Mambix/TroublemakerMX/README.md

# TroublemakerMX
Upgrade of Troublemaker 3D printer
