Mambix/TroublemakerMX/pdf/6mm_gravura_prva_stran.pdf

5-*-6

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
# HEATBED

# HOTEND II

# HOTEND I

## NONE

## NONE

## Z-MAX

## Z-MIN

## Y-MAX

## Y-MIN

## X-MAX

## X-MIN

GND
OUT
5V | - A | + D595/7
