Mambix/TroublemakerMX/dxf/6mm_plywood_cut_front_back.dxf

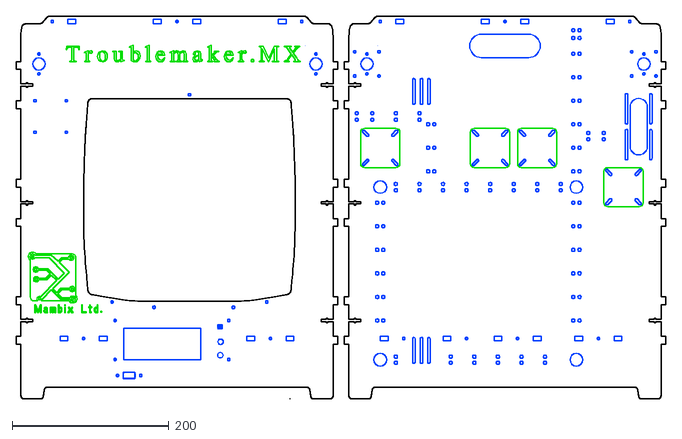
[picture p1: CAD file, 2021-01-03]
dxf/6mm_plywood_cut_front_back.dxf
828.0 x 488.0
