Mambix/TroublemakerMX/dxf/blocks/6mm_les_izrez_desno - LM8UU.dxf

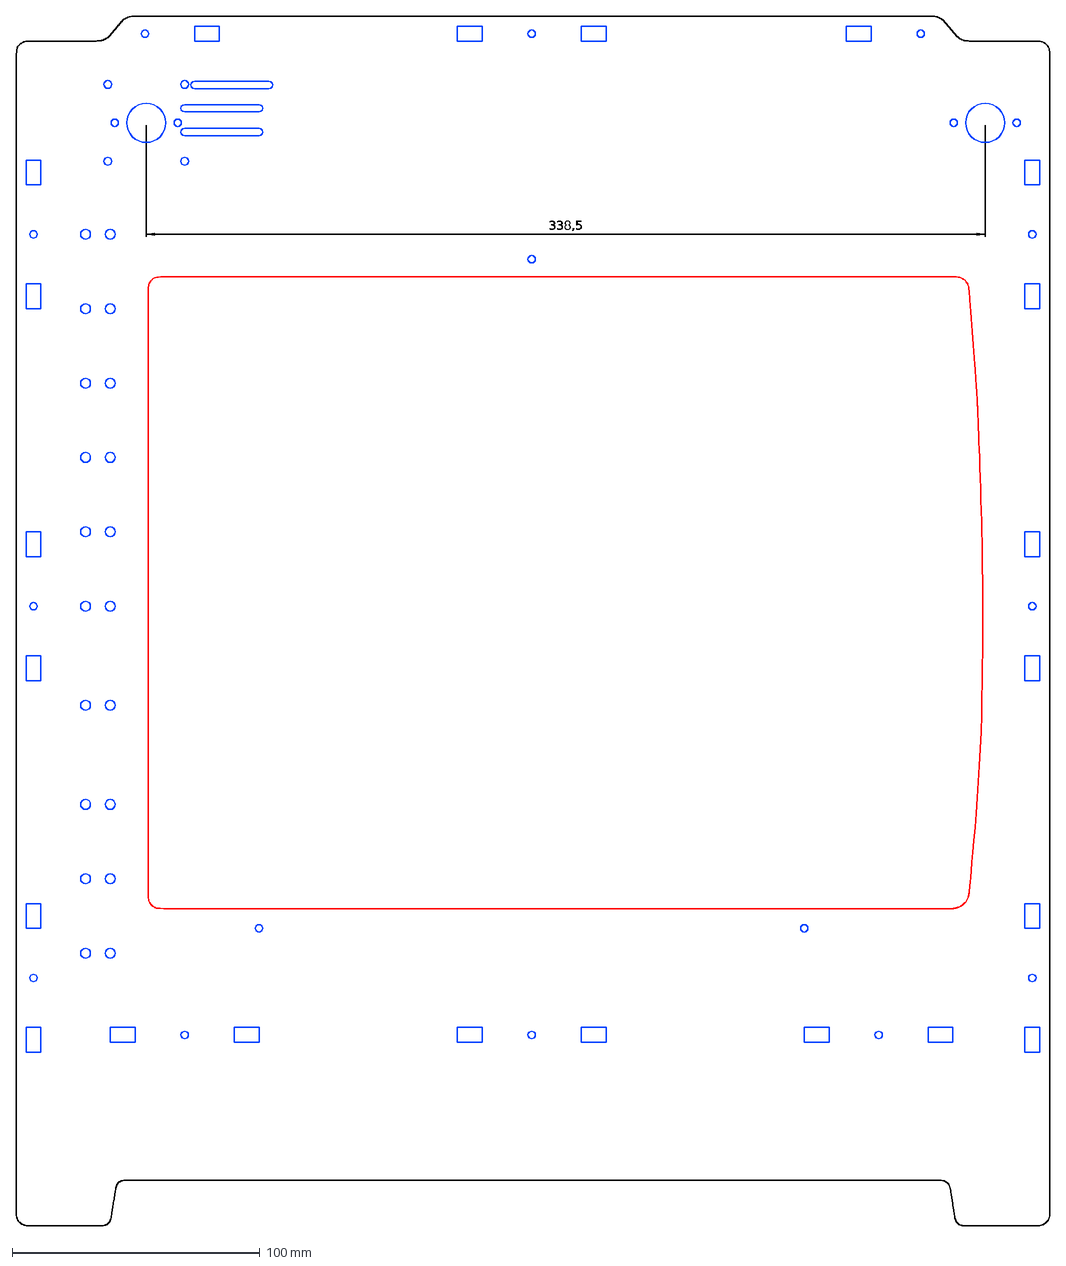
[picture p2: CAD file, 2021-01-03]
dxf/blocks/6mm_les_izrez_desno - LM8UU.dxf
338,5
