Mambix/TroublemakerMX/FreeCAD/LM8UU BallBearing Carrige #2.FCStd

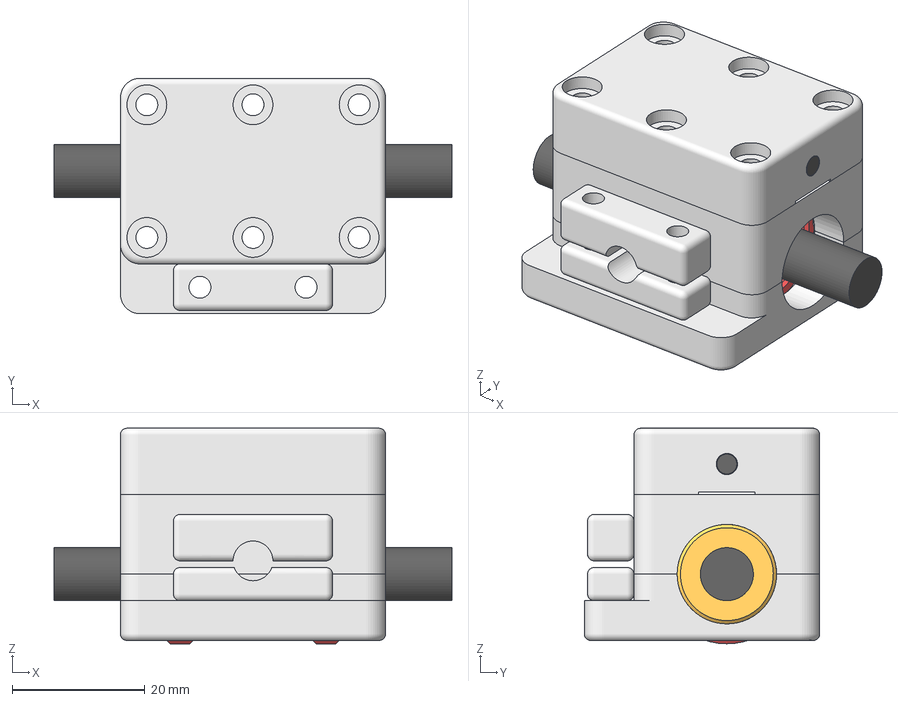
[picture p3: CAD file, 2017-03-12]
FreeCAD/LM8UU BallBearing Carrige #2.FCStd
60.0 x 35.5 x 32.5 mm
LM8UU
SUPPORT BOTTOM
SUPPORT TOP
6702ZZ #1
6702ZZ #2
TOP
BOTTOM
MIDDLE
GripPart
