Mambix/TroublemakerMX/stl/movedTOP.stl

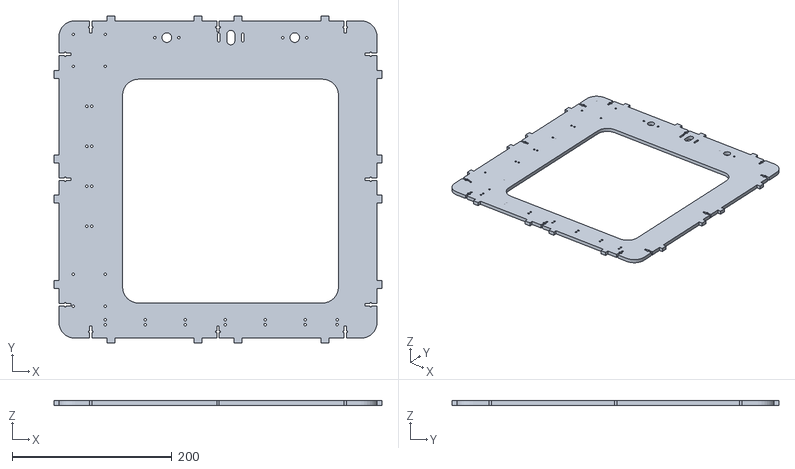
[picture p4: CAD file, 2021-01-03]
stl/movedTOP.stl
410.0 x 409.0 x 6.00
