Mambix/TroublemakerMX/dxf/6mm_plywood_cut_left_right.dxf

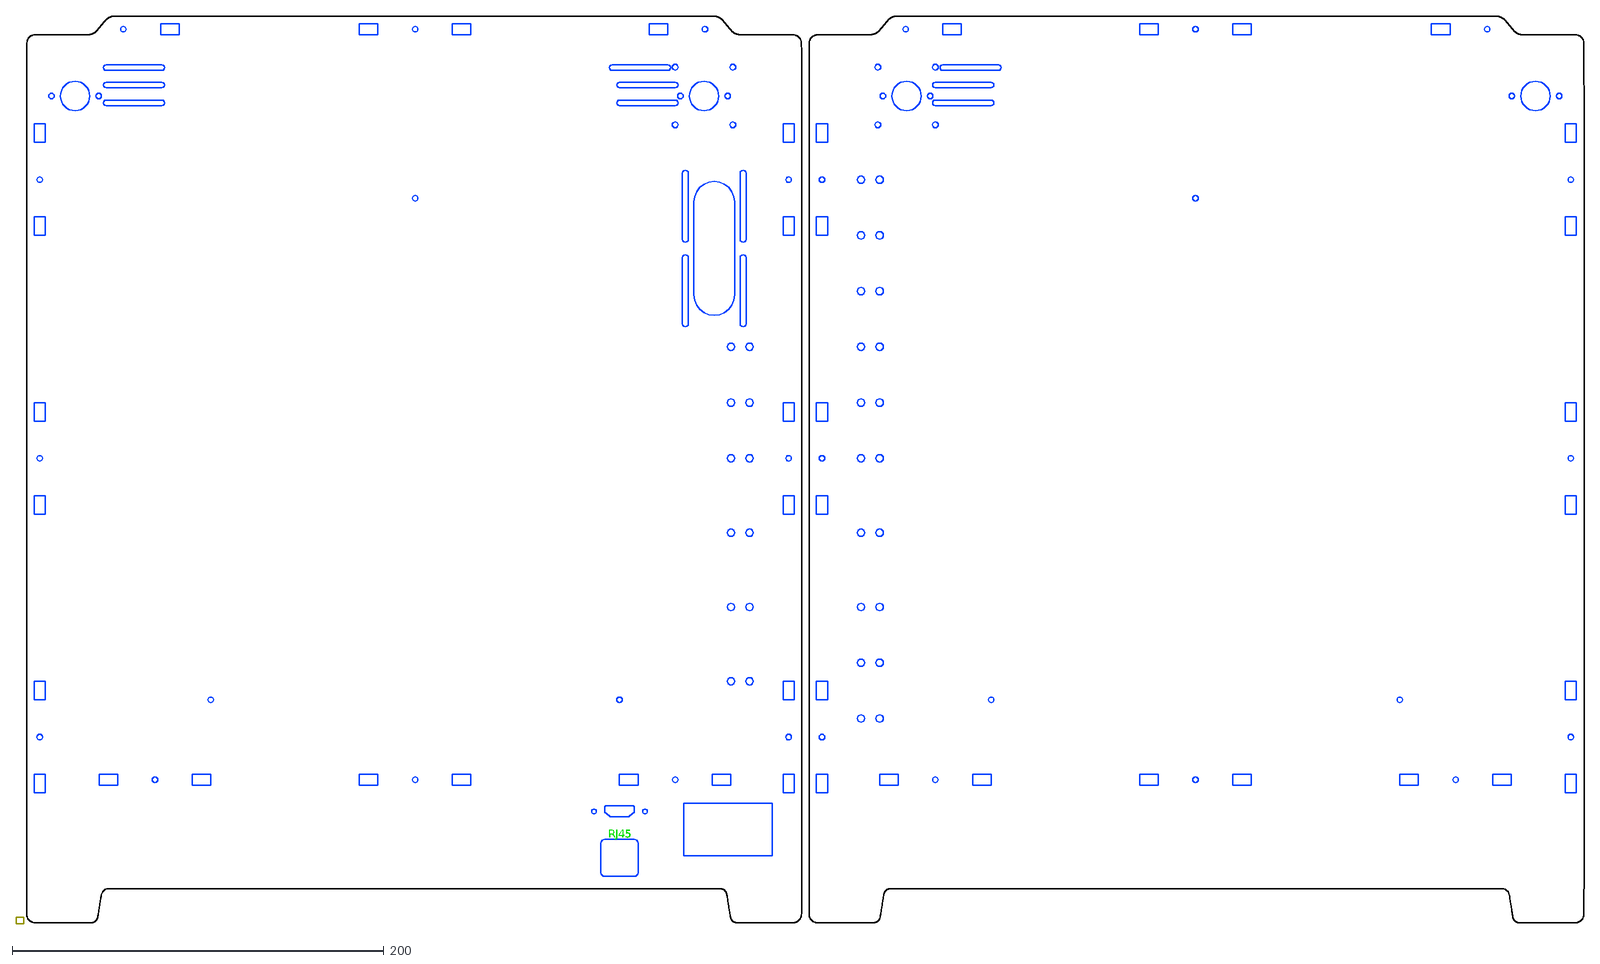
[picture p5: CAD file, 2021-01-03]
dxf/6mm_plywood_cut_left_right.dxf
RJ45
