Mambix/TroublemakerMX/dxf/blocks/6mm_les_izrez_levo - LM8UU.dxf

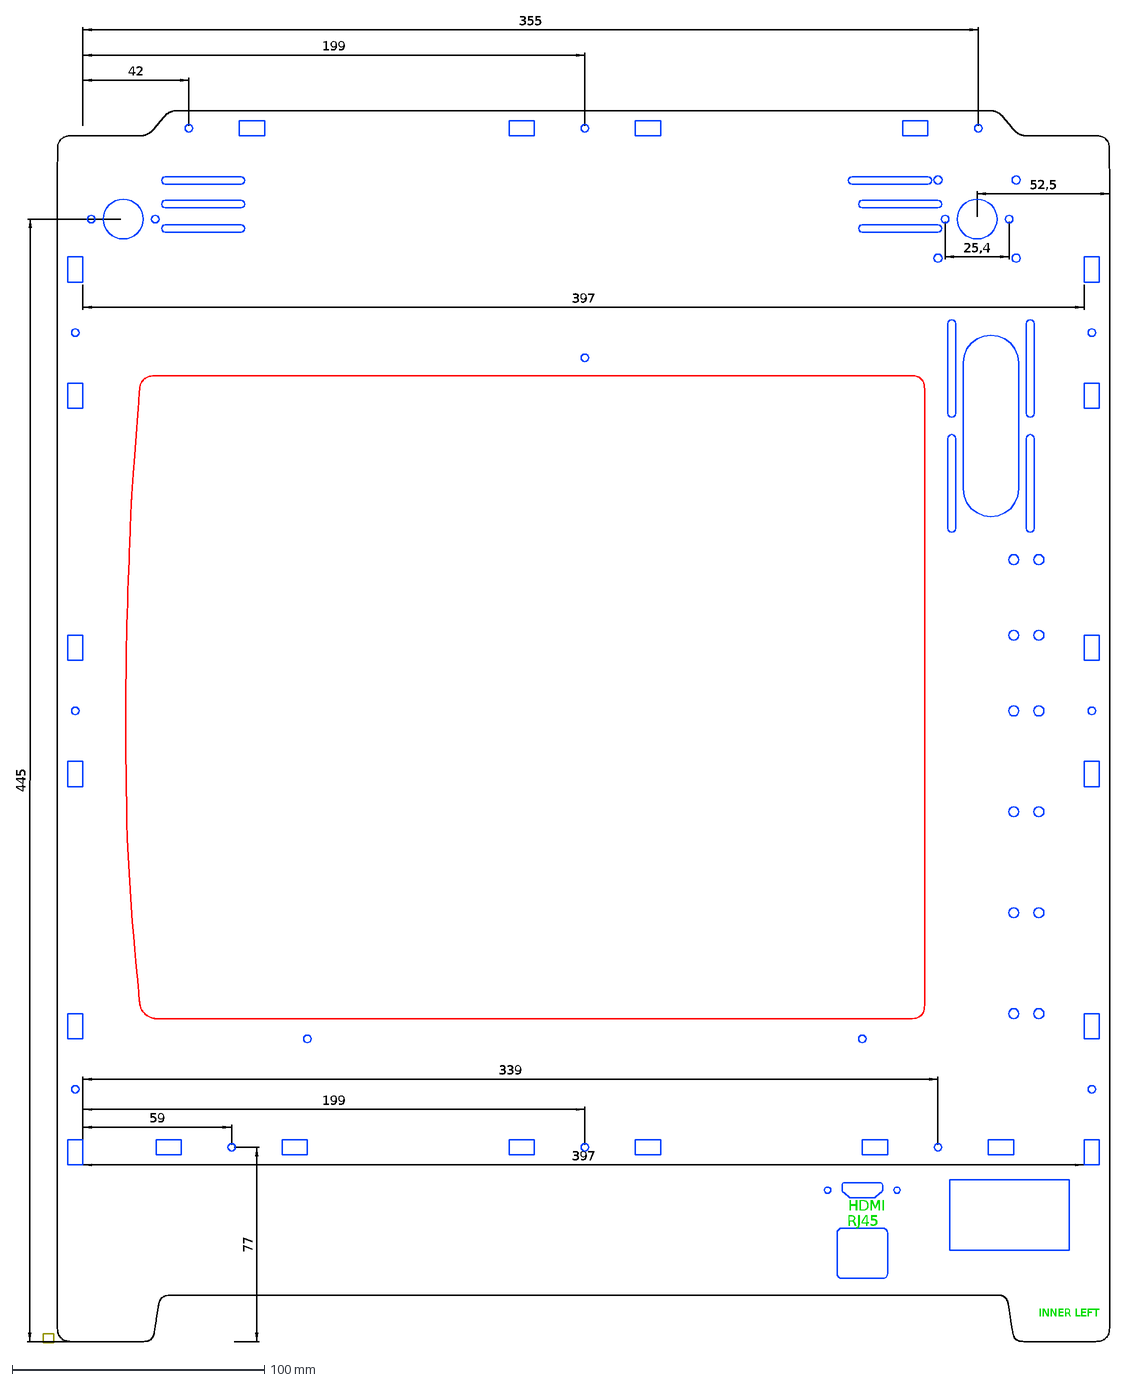
[picture p6: CAD file, 2021-01-03]
dxf/blocks/6mm_les_izrez_levo - LM8UU.dxf
INNER LEFT
77
397
42
199
355
59
339
25,4
445
HDMI
RJ45
52,5
