Mambix/TroublemakerMX/FreeCAD/3D Model.FCStd

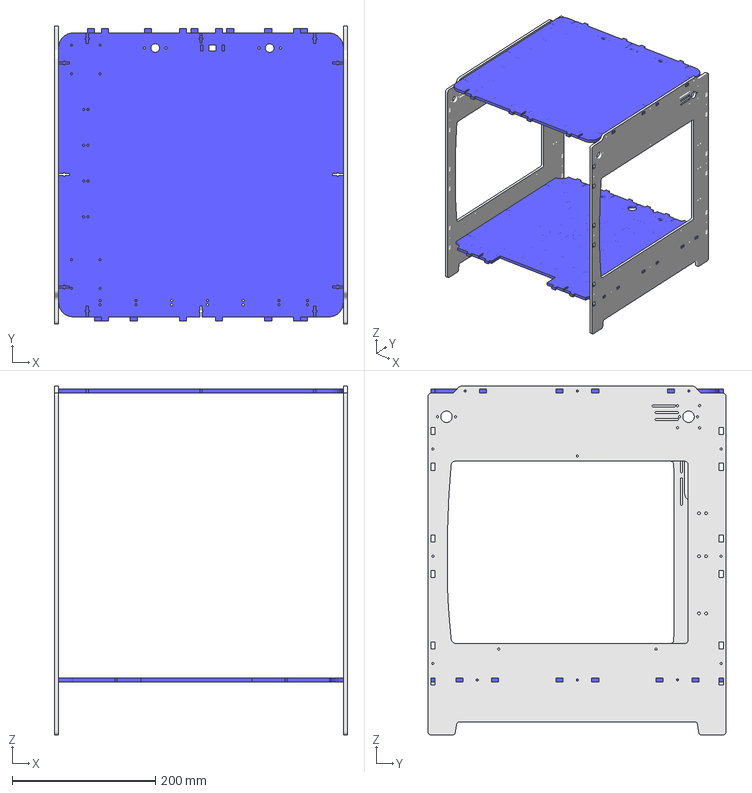
[picture p7: CAD file, 2017-03-03]
FreeCAD/3D Model.FCStd
410.0 x 417.1 x 488.0 mm
movedDOL
movedGOR
movedDESNO
movedLEVO
