Mambix/TroublemakerMX/stl/movedHE_BOTTOM.stl

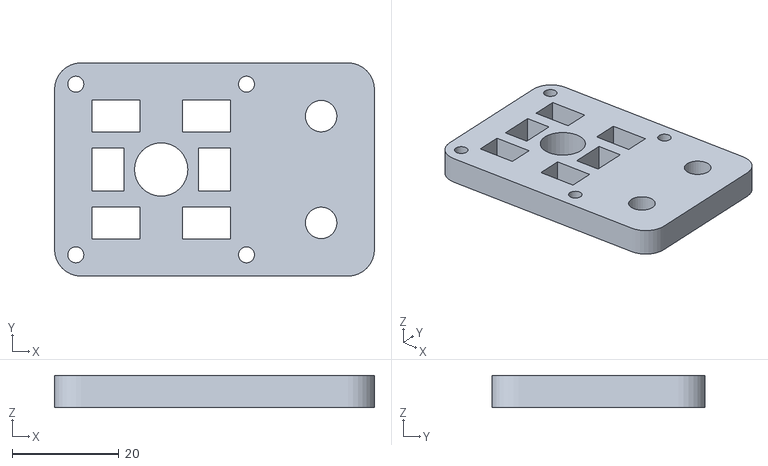
[picture p8: CAD file, 2021-01-03]
stl/movedHE_BOTTOM.stl
60.0 x 40.0 x 6.00
