Mambix/TroublemakerMX/dxf/6mm_plywood_cut_top_bottom.dxf

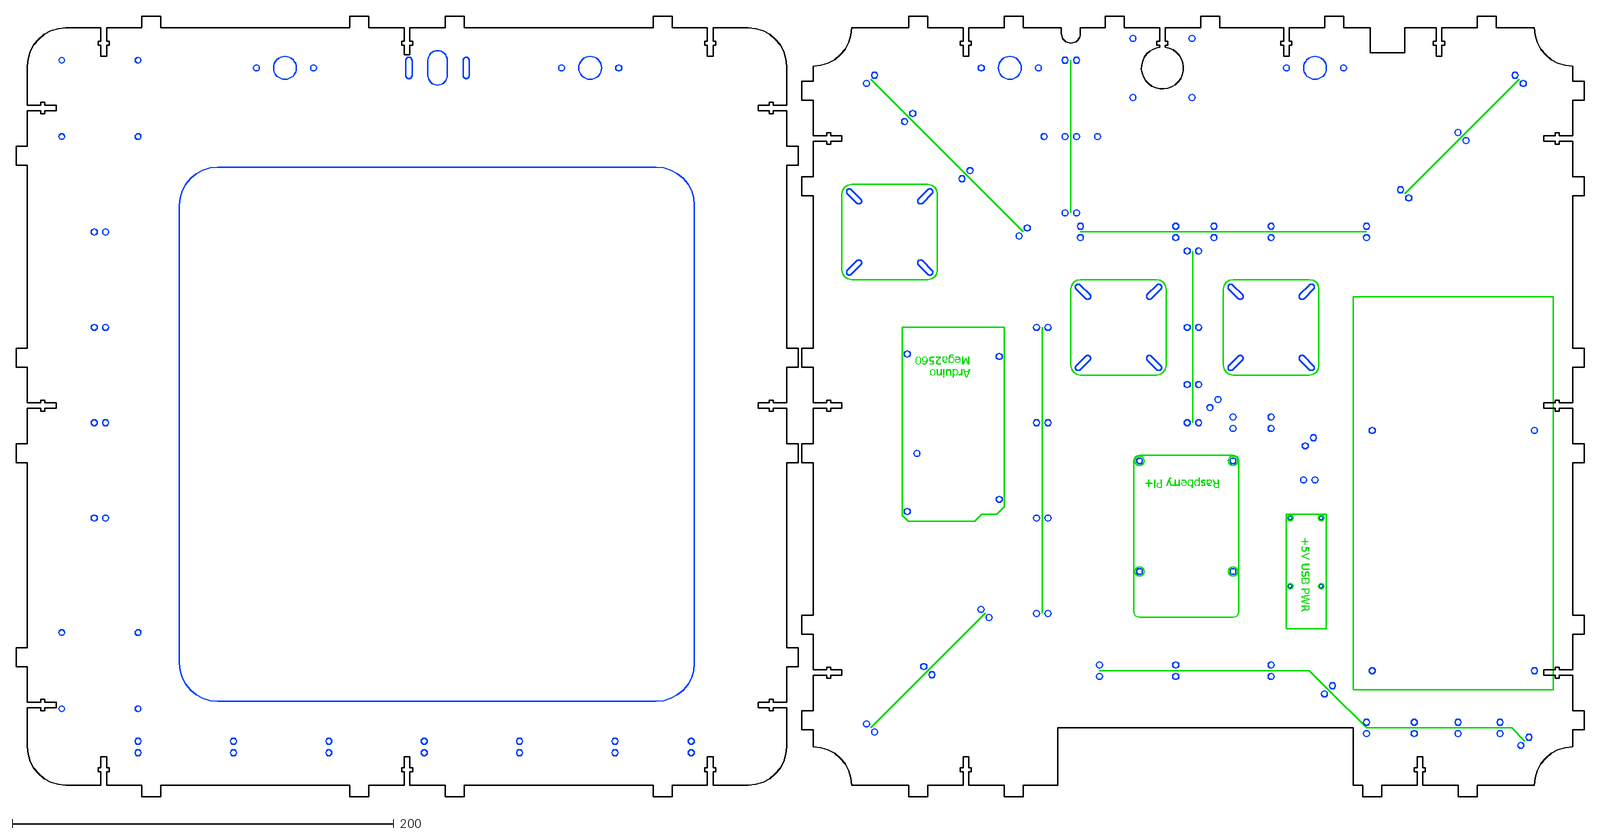
[picture p9: CAD file, 2021-01-03]
dxf/6mm_plywood_cut_top_bottom.dxf
Arduino Mega2560
Raspberry PI+
+5V USB PWR
