Mambix/TroublemakerMX/dxf/blocks/6mm_les_izrez_dol - LM8UU.dxf

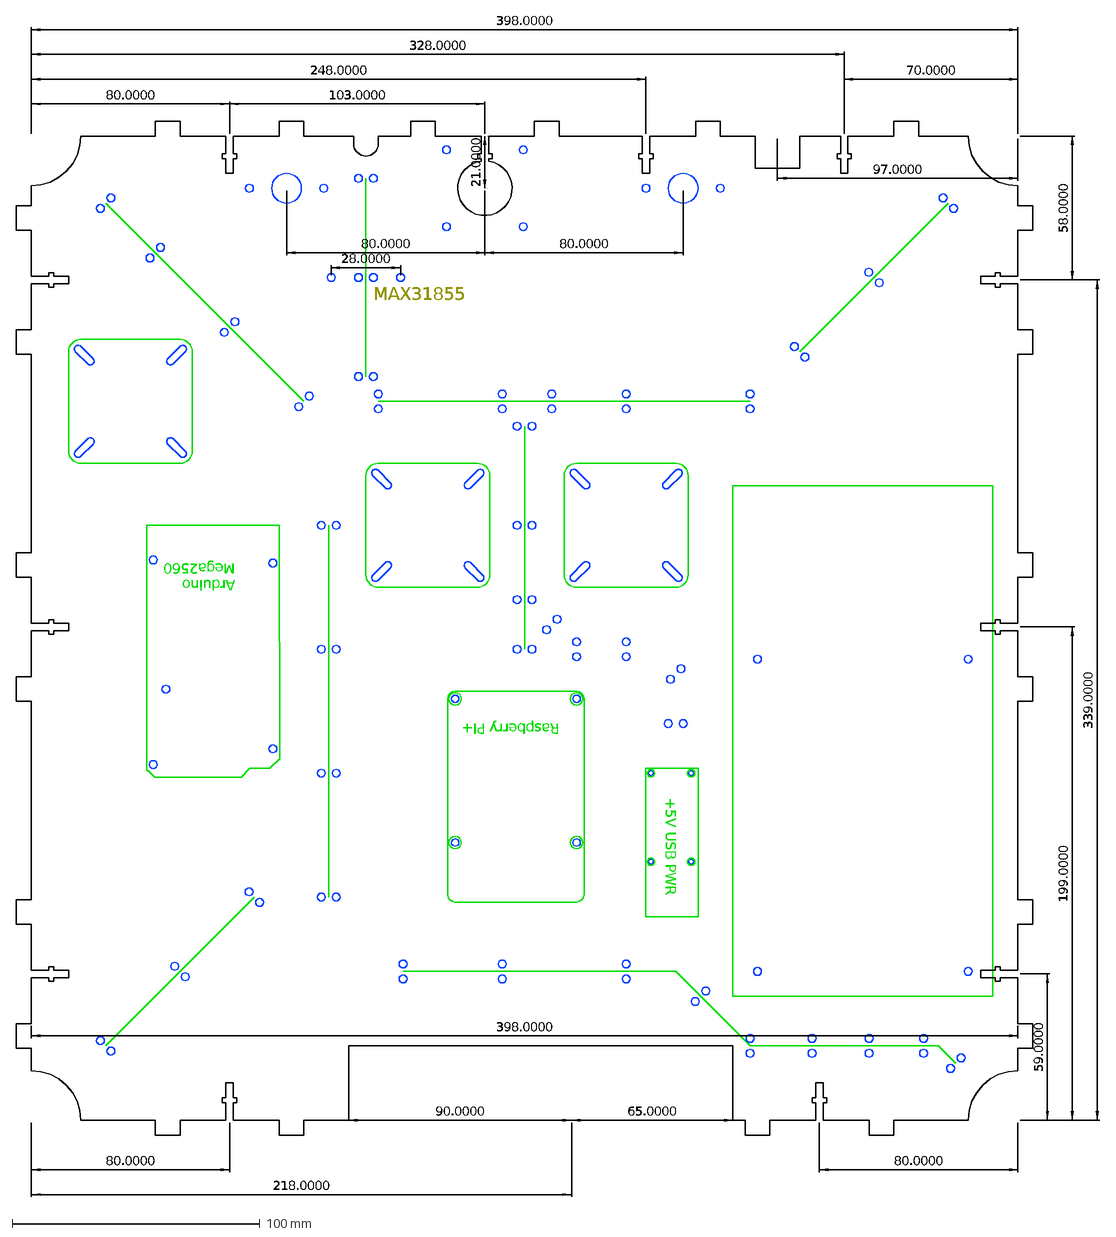
[picture p10: CAD file, 2021-01-03]
dxf/blocks/6mm_les_izrez_dol - LM8UU.dxf
MAX31855
Arduino Mega2560
Raspberry PI+
+5V USB PWR
248.0000
328.0000
70.0000
398.0000
80.0000
103.0000
21.0000
97.0000
58.0000
339.0000
199.0000
28.0000
218.0000
90.0000
65.0000
59.0000
