Mambix/TroublemakerMX/FreeCAD/3D Model gor dol.FCStd

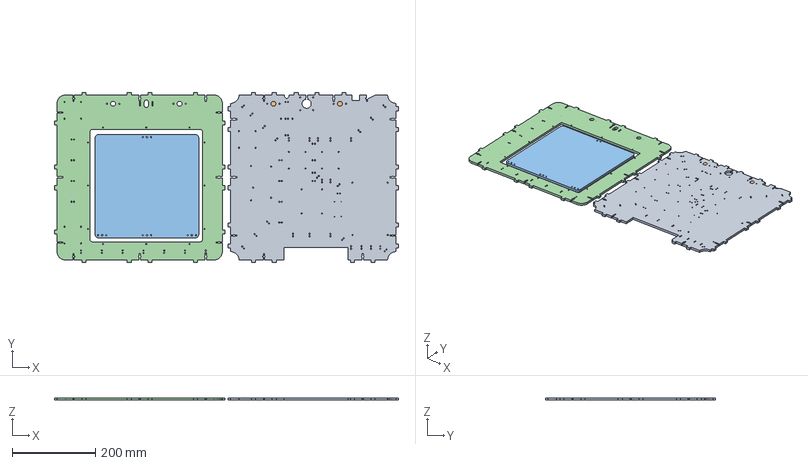
[picture p11: CAD file, 2017-02-22]
FreeCAD/3D Model gor dol.FCStd
828.0 x 409.0 x 6.00 mm
BOTTOM
TABLE
TOP
