Mambix/TroublemakerMX/stl/movedBOTTOM.stl

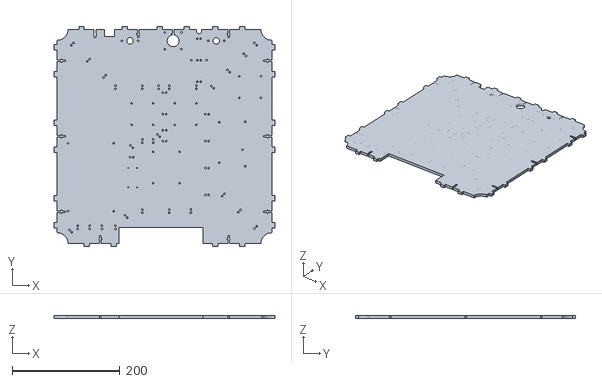
[picture p12: CAD file, 2021-01-03]
stl/movedBOTTOM.stl
410.0 x 409.0 x 6.00
