Mambix/TroublemakerMX/dxf/6mm_plexi_cut_windows.dxf

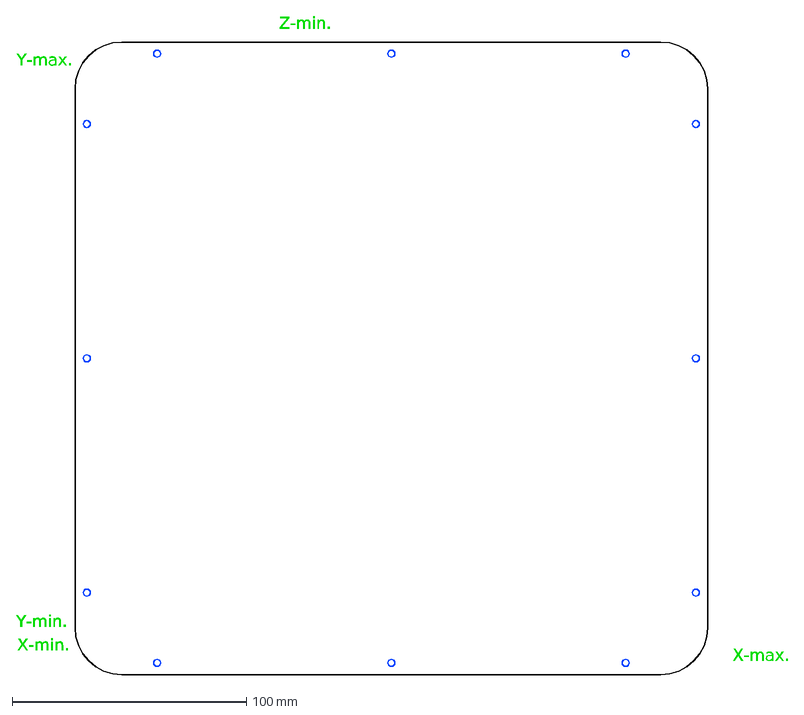
[picture p13: CAD file, 2018-02-03]
dxf/6mm_plexi_cut_windows.dxf
X-min.
Y-min.
Y-max.
Z-min.
X-max.
