Mambix/TroublemakerMX/dxf/blocks/6mm_les_izrez_zadaj - LM8UU.dxf

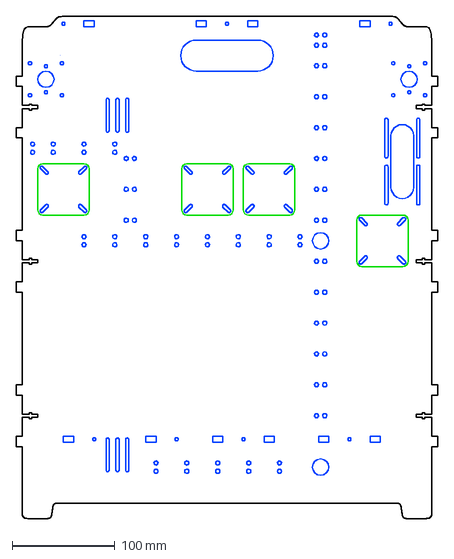
[picture p14: CAD file, 2021-01-03]
dxf/blocks/6mm_les_izrez_zadaj - LM8UU.dxf
410.0 x 488.0 mm
