Mambix/TroublemakerMX/FreeCAD/LM8UU BallBearing Carrige.FCStd

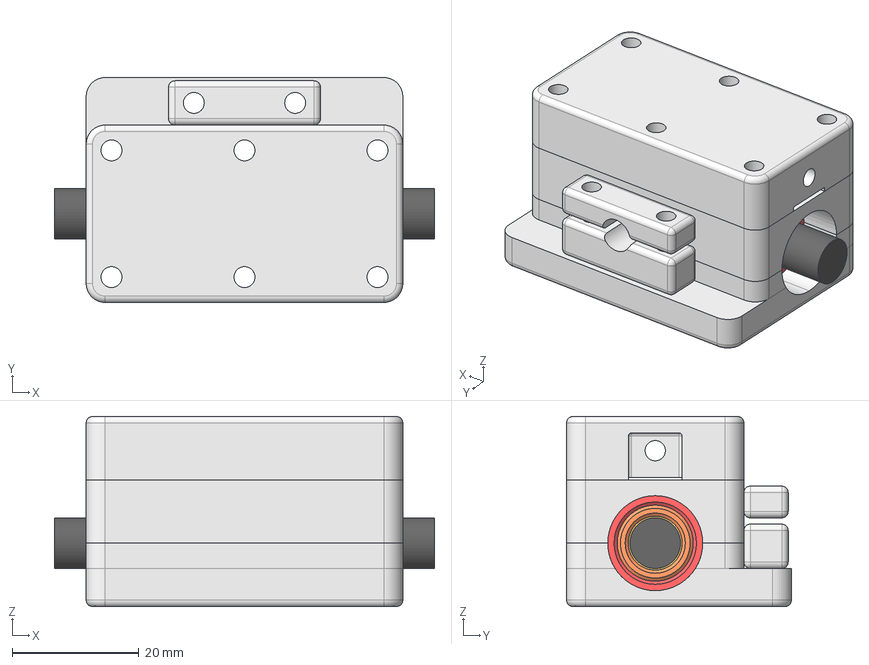
[picture p15: CAD file, 2017-02-22]
FreeCAD/LM8UU BallBearing Carrige.FCStd
60.0 x 35.5 x 30.0 mm
LM8UU
SUPPORT BOTTOM
SUPPORT TOP
MIDDLE
BOTTOM
6701ZZ #1
6701ZZ #2
BB Holder #1
BB Holder #2
TOP
