Mambix/TroublemakerMX/stl/movedLEFT.stl

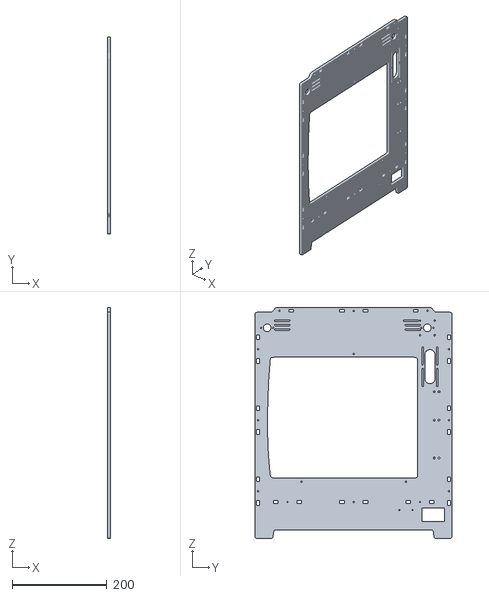
[picture p16: CAD file, 2021-01-03]
stl/movedLEFT.stl
6.00 x 417.1 x 488.0
