Mambix/TroublemakerMX/dxf/blocks/6mm_les_izrez_hotend_bottom.dxf

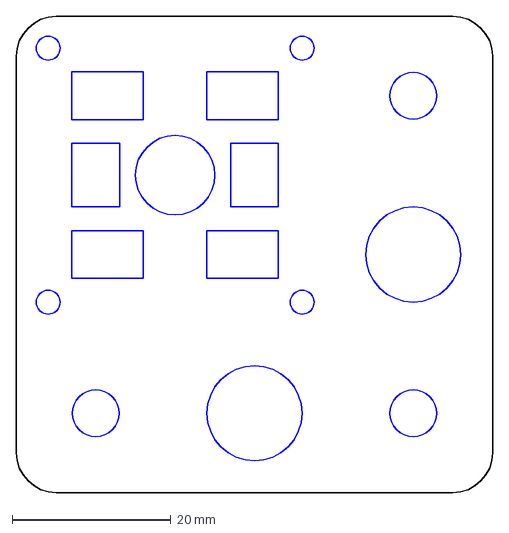
[picture p17: CAD file, 2021-01-02]
dxf/blocks/6mm_les_izrez_hotend_bottom.dxf
60.0 x 60.0 mm
