Mambix/TroublemakerMX/FreeCAD/3D Model left right.FCStd

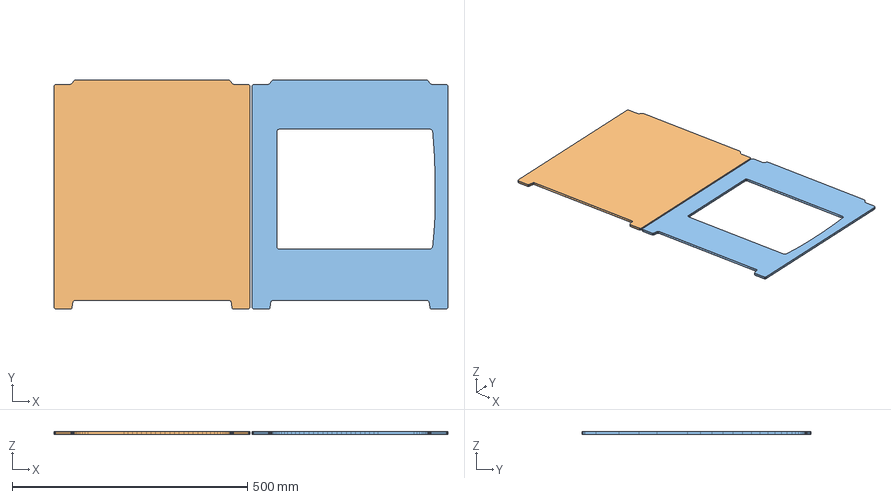
[picture p18: CAD file, 2017-02-22]
FreeCAD/3D Model left right.FCStd
838.2 x 488.0 x 6.00 mm
