Mambix/TroublemakerMX/stl/movedHE_TOP.stl

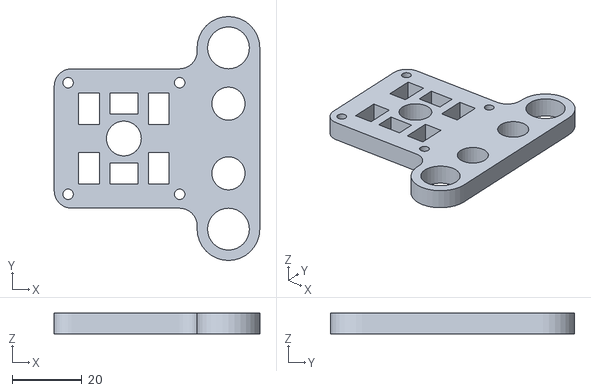
[picture p19: CAD file, 2021-01-03]
stl/movedHE_TOP.stl
59.0 x 70.0 x 6.00
