Mambix/TroublemakerMX/dxf/blocks/6mm_les_izrez_hotend_top2.dxf

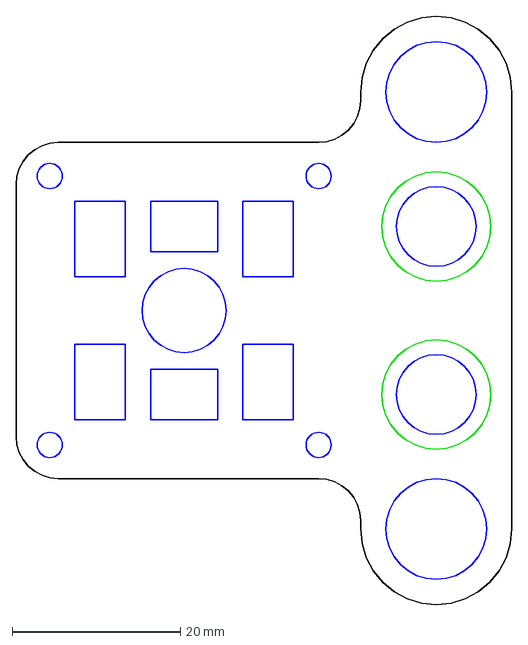
[picture p20: CAD file, 2021-01-02]
dxf/blocks/6mm_les_izrez_hotend_top2.dxf
59.0 x 70.0 mm
