Mambix/TroublemakerMX/dxf/miza.dxf

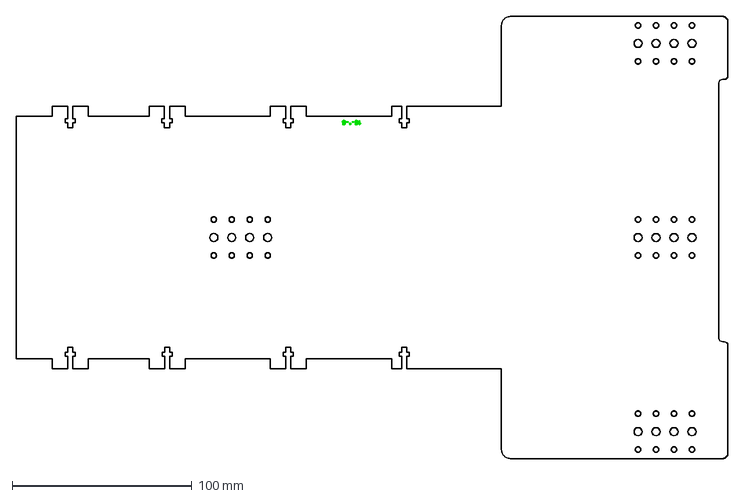
[picture p21: CAD file, 2017-02-22]
dxf/miza.dxf
396.0 x 246.0 mm
