Mambix/TroublemakerMX/stl/movedTABLE.stl

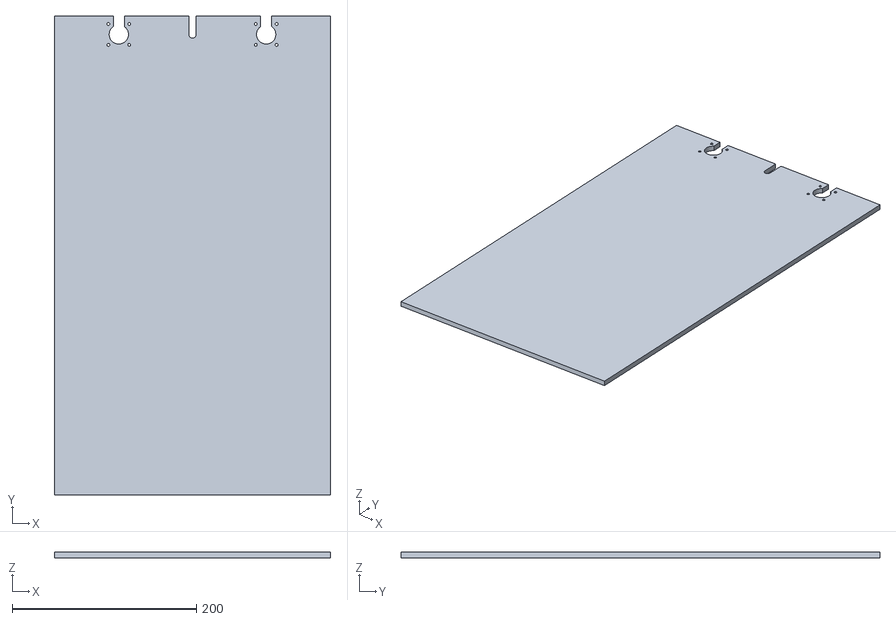
[picture p22: CAD file, 2021-01-03]
stl/movedTABLE.stl
300.0 x 520.0 x 6.00
