Mambix/TroublemakerMX/dxf/4mm_deli.dxf

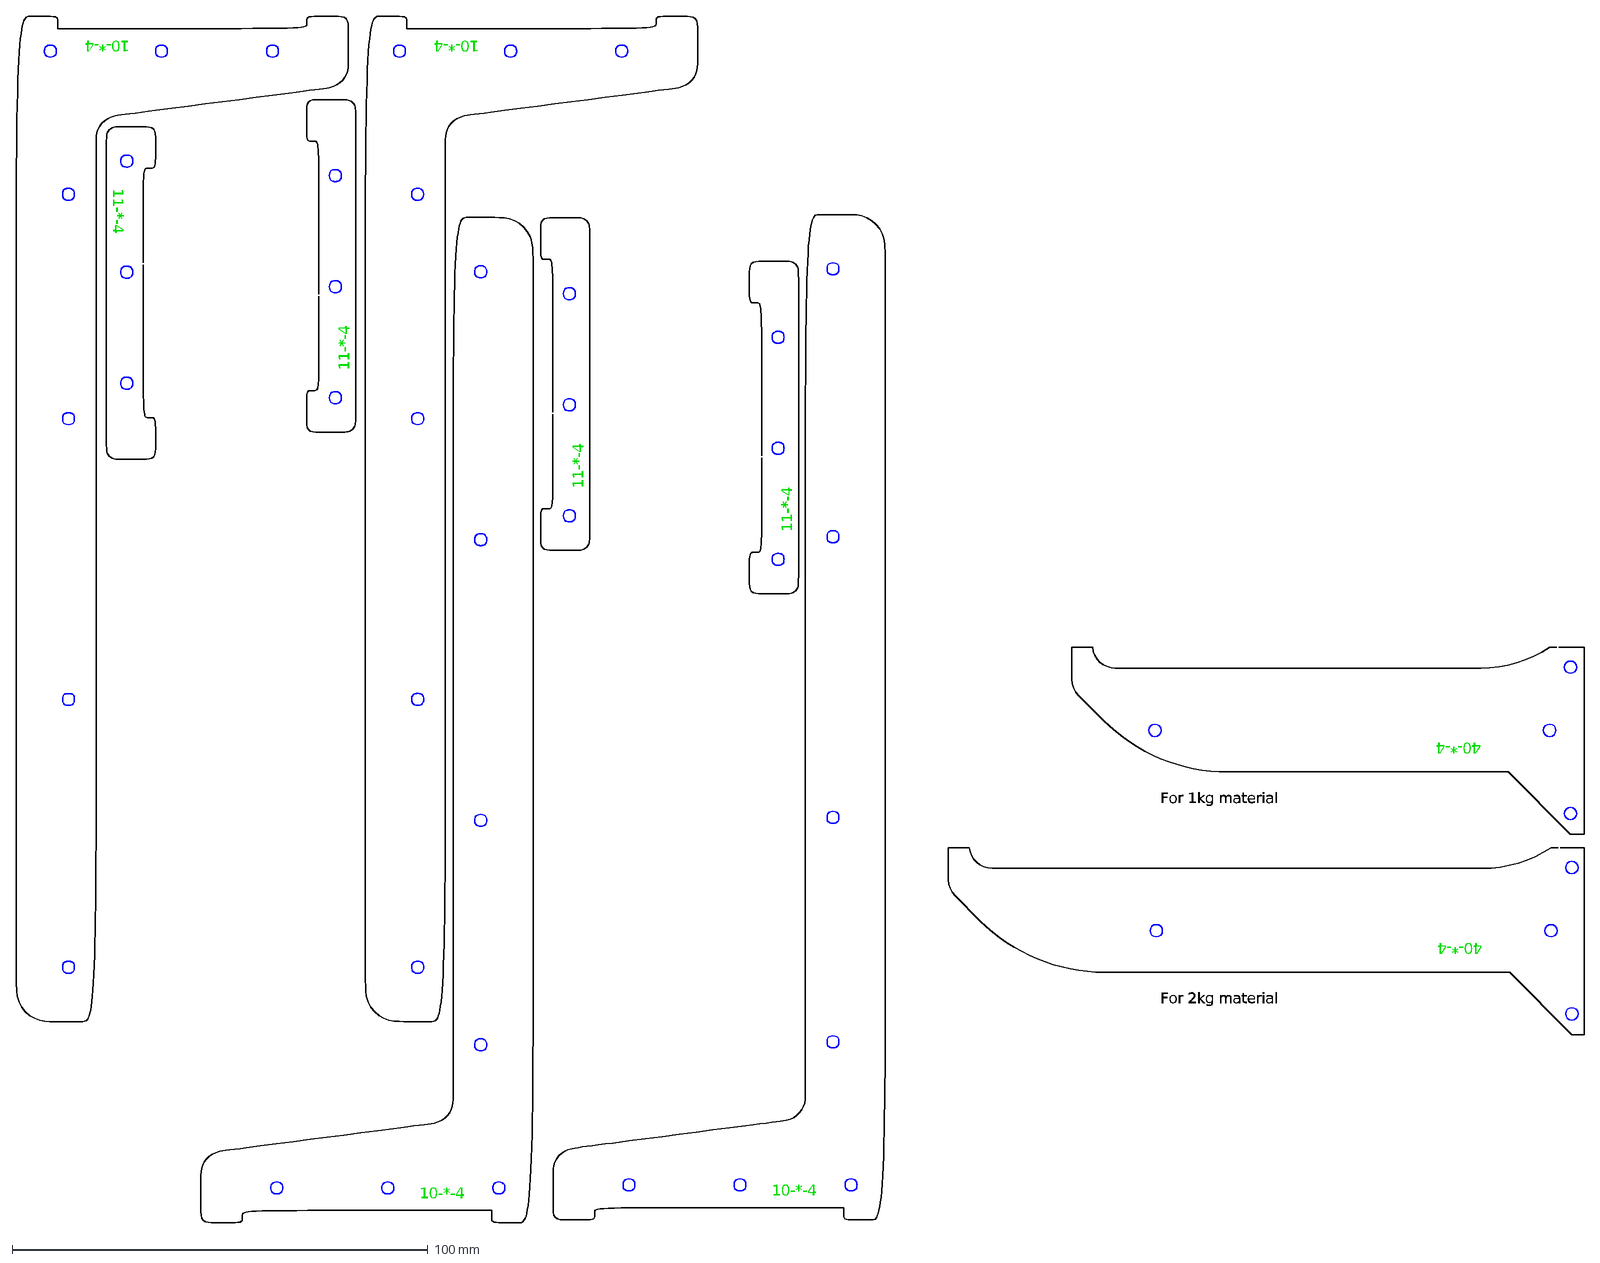
[picture p23: CAD file, 2017-02-22]
dxf/4mm_deli.dxf
10-*-4
11-*-4
40-*-4
For 2kg material
For 1kg material
