Mambix/TroublemakerMX/FreeCAD/LM8UU Carrige.FCStd

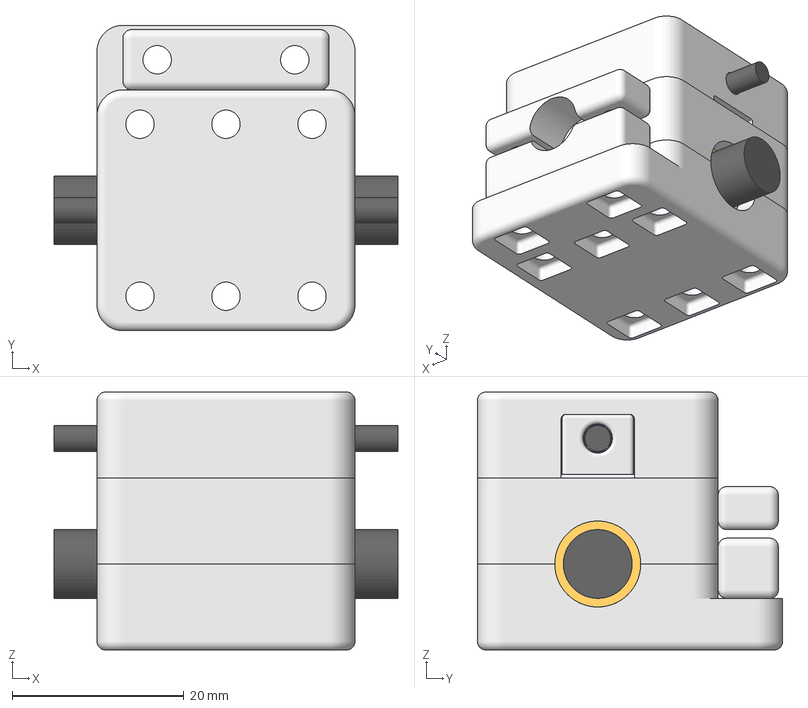
[picture p25: CAD file, 2015-04-25]
FreeCAD/LM8UU Carrige.FCStd
40.0 x 35.5 x 30.0 mm
LM8UU
SUPPORT BOTTOM
SUPPORT TOP
MIDDLE
TOP
BOTTOM
GripPart
