Mambix/TroublemakerMX/stl/movedRIGHT.stl

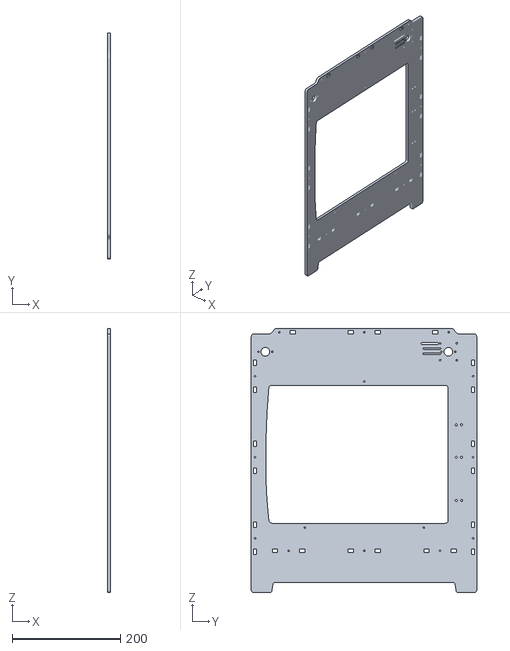
[picture p26: CAD file, 2021-01-03]
stl/movedRIGHT.stl
6.00 x 417.1 x 488.0
