Mambix/TroublemakerMX/dxf/6mm_plexi.dxf

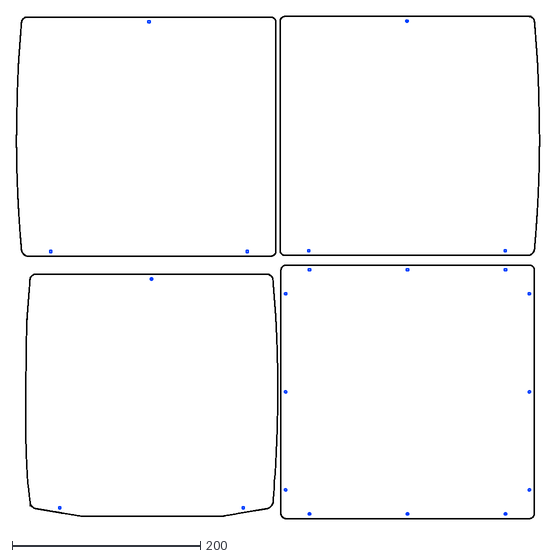
[picture p27: CAD file, 2015-04-15]
dxf/6mm_plexi.dxf
555.8 x 533.6
