Mambix/TroublemakerMX/dxf/blocks/6mm_les_izrez_table_holder_LMK12LUU.dxf

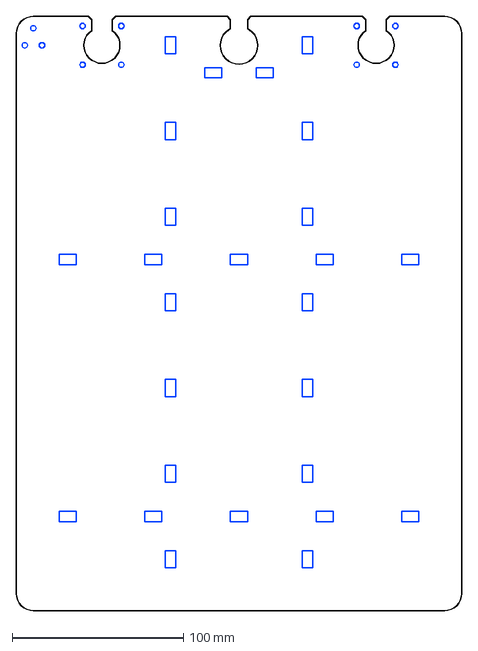
[picture p28: CAD file, 2021-01-02]
dxf/blocks/6mm_les_izrez_table_holder_LMK12LUU.dxf
260.0 x 347.0 mm
