Mambix/TroublemakerMX/stl/movedFRONT.stl

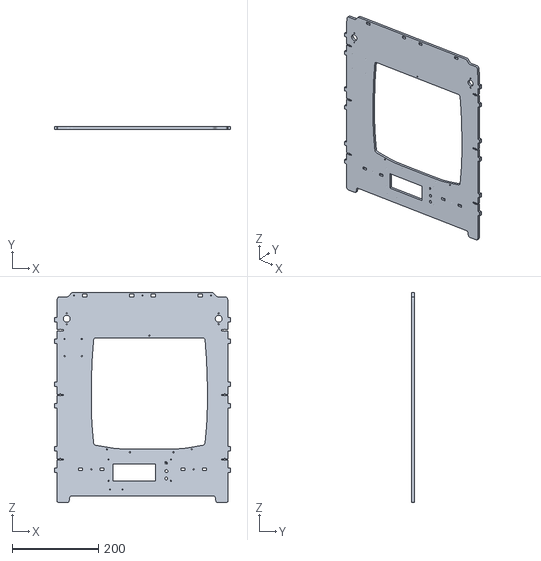
[picture p29: CAD file, 2021-01-03]
stl/movedFRONT.stl
410.0 x 6.00 x 488.0
