Mambix/TroublemakerMX/dxf/blocks/6mm_les_izrez_table_wall_LMK12LUU.dxf

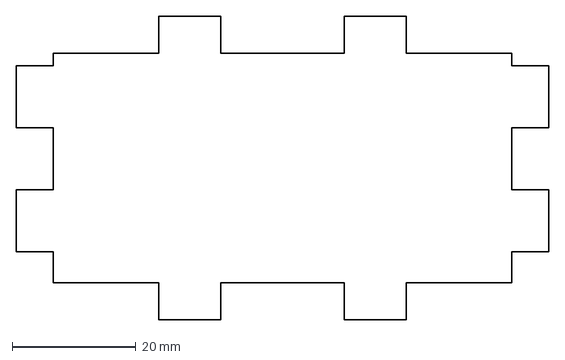
[picture p30: CAD file, 2021-01-02]
dxf/blocks/6mm_les_izrez_table_wall_LMK12LUU.dxf
86.0 x 49.0 mm
