Mambix/TroublemakerMX/dxf/gumb.dxf

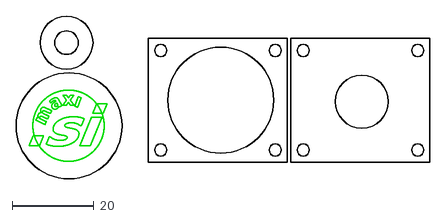
[picture p31: CAD file, 2015-04-15]
dxf/gumb.dxf
101.5 x 39.9
