Mambix/TroublemakerMX/stl/movedBACK.stl

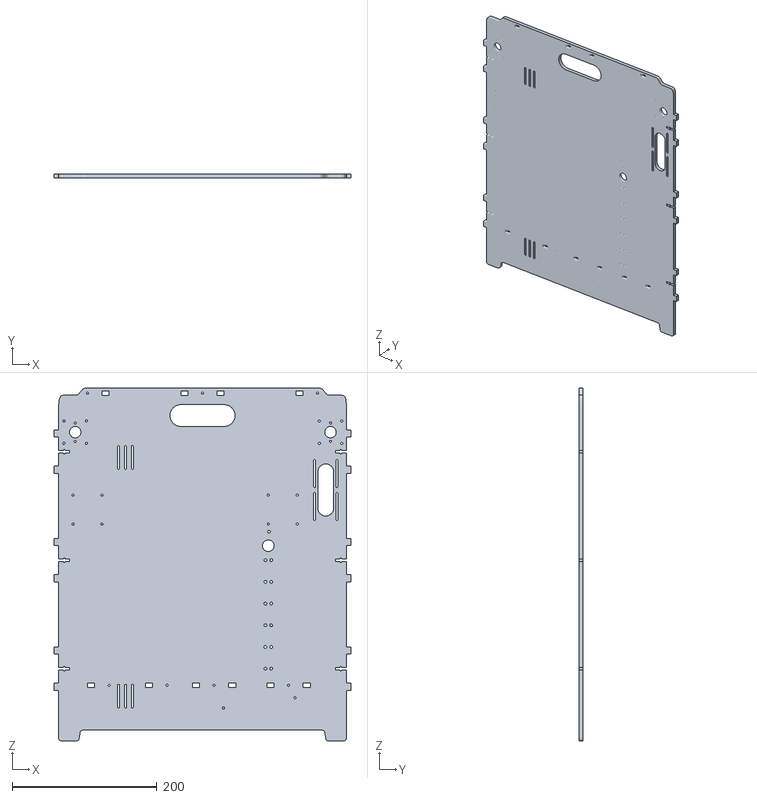
[picture p32: CAD file, 2021-01-03]
stl/movedBACK.stl
410.0 x 6.00 x 488.0
