Mambix/TroublemakerMX/dxf/BeltAligner.dxf

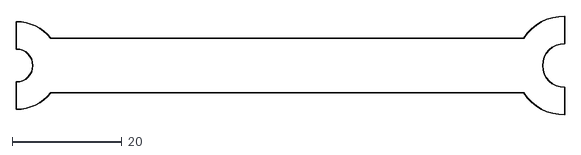
[picture p33: CAD file, 2015-04-15]
dxf/BeltAligner.dxf
100.0 x 18.0
