Mambix/TroublemakerMX/dxf/blocks/6mm_les_izrez_gor - LMH12UU.dxf

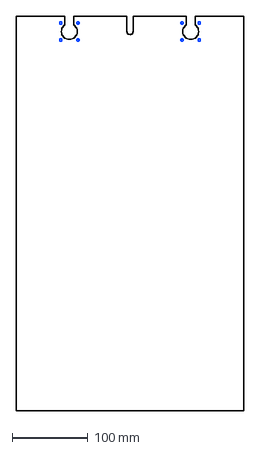
[picture p34: CAD file, 2021-01-02]
dxf/blocks/6mm_les_izrez_gor - LMH12UU.dxf
300.0 x 520.0 mm
