Mambix/TroublemakerMX/stl/movedHE_RIGHT.stl

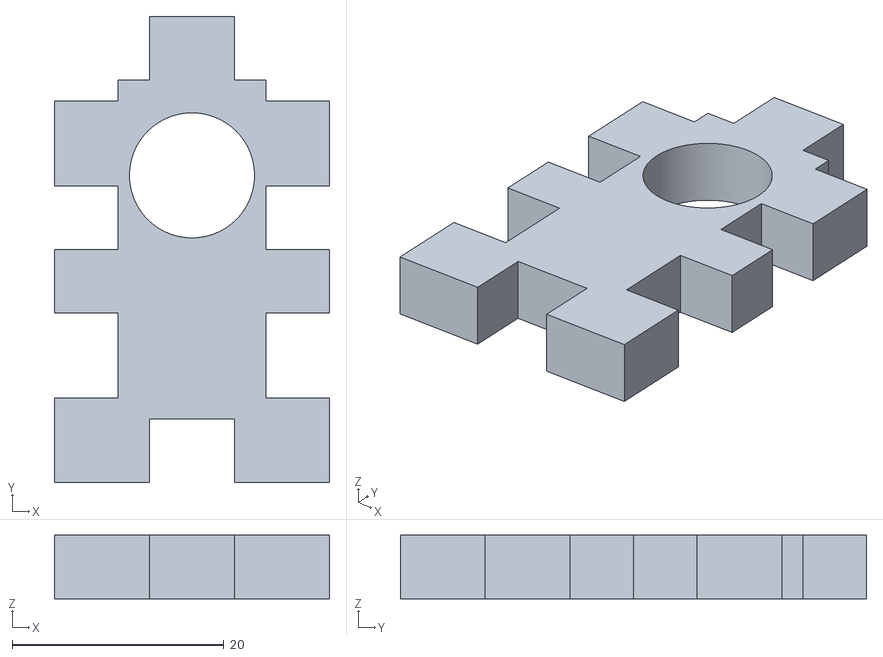
[picture p35: CAD file, 2018-02-03]
stl/movedHE_RIGHT.stl
26.0 x 44.0 x 6.00
