Mambix/TroublemakerMX/dxf/6mm_gravura_prva_stran.dxf

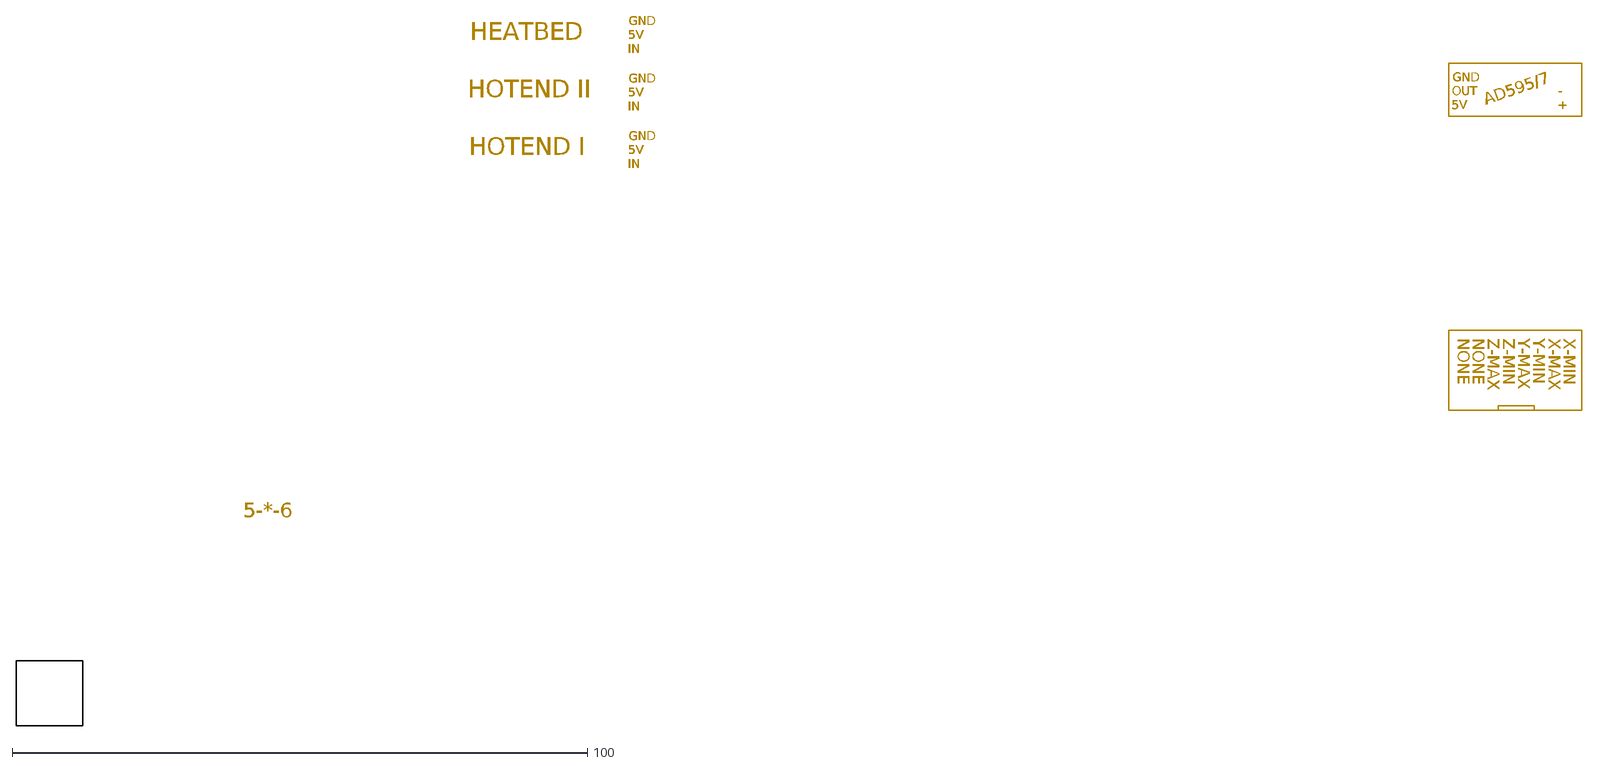
[picture p36: CAD file, 2015-04-15]
dxf/6mm_gravura_prva_stran.dxf
5-*-6
GND
5V
IN
HEATBED
HOTEND II
HOTEND I
X-MIN
X-MAX
Y-MIN
Y-MAX
Z-MIN
Z-MAX
NONE
OUT
-
+
AD595/7
