Mambix/TroublemakerMX/dxf/blocks/6mm_les_izrez_hotend_side_6.5.dxf

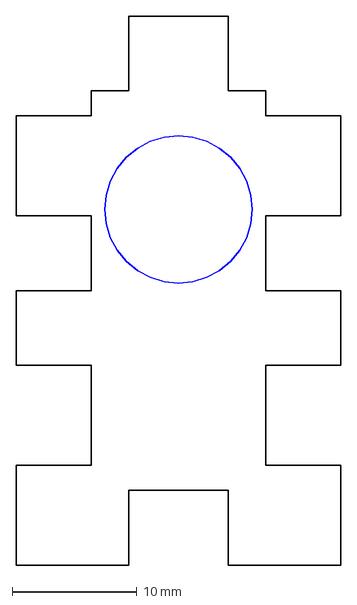
[picture p37: CAD file, 2021-01-02]
dxf/blocks/6mm_les_izrez_hotend_side_6.5.dxf
26.0 x 44.0 mm
