Mambix/TroublemakerMX/stl/Carrige #2.stl

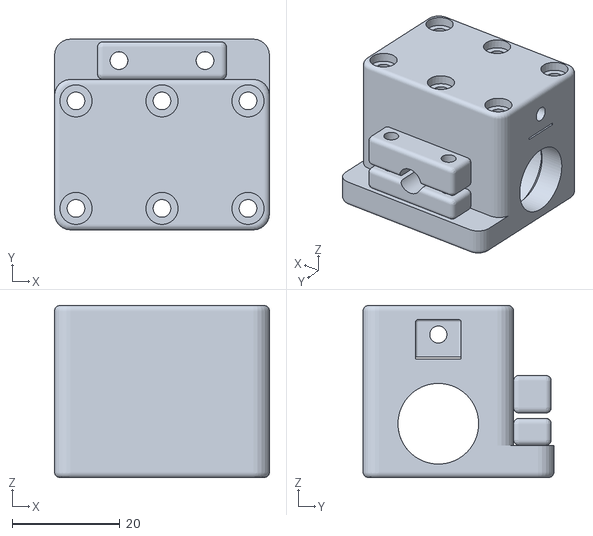
[picture p38: CAD file, 2017-03-12]
stl/Carrige #2.stl
40.0 x 35.5 x 32.0
