Mambix/TroublemakerMX/dxf/blocks/6mm_les_izrez_hotend_side_9.dxf

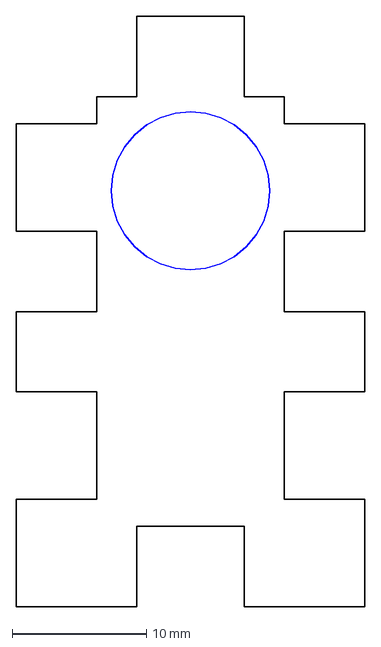
[picture p39: CAD file, 2021-01-02]
dxf/blocks/6mm_les_izrez_hotend_side_9.dxf
26.0 x 44.0 mm
