Mambix/TroublemakerMX/dxf/blocks/6mm_les_izrez_hotend_bottom2.dxf

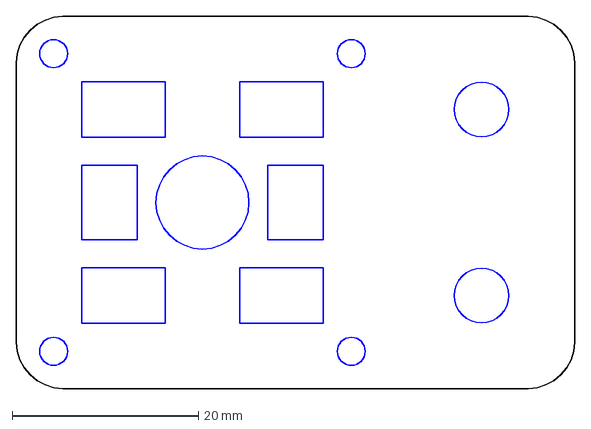
[picture p40: CAD file, 2021-01-02]
dxf/blocks/6mm_les_izrez_hotend_bottom2.dxf
60.0 x 40.0 mm
