Mambix/TroublemakerMX/dxf/blocks/6mm_les_izrez_table_sides_LMK12LUU.dxf

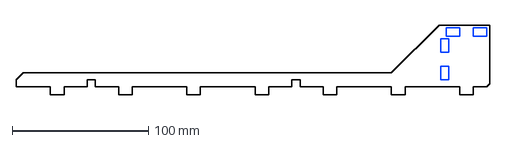
[picture p41: CAD file, 2021-01-02]
dxf/blocks/6mm_les_izrez_table_sides_LMK12LUU.dxf
347.0 x 51.0 mm
