Mambix/TroublemakerMX/dxf/blocks/6mm_les_izrez_hotend_side_6.dxf

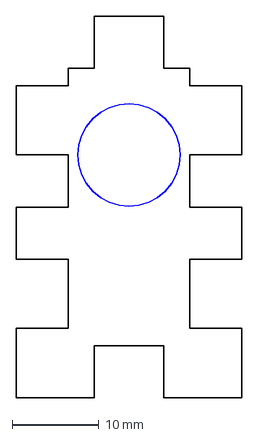
[picture p42: CAD file, 2021-01-02]
dxf/blocks/6mm_les_izrez_hotend_side_6.dxf
26.0 x 44.0 mm
