Mambix/TroublemakerMX/dxf/blocks/6mm_les_izrez_gor - LM8UU.dxf

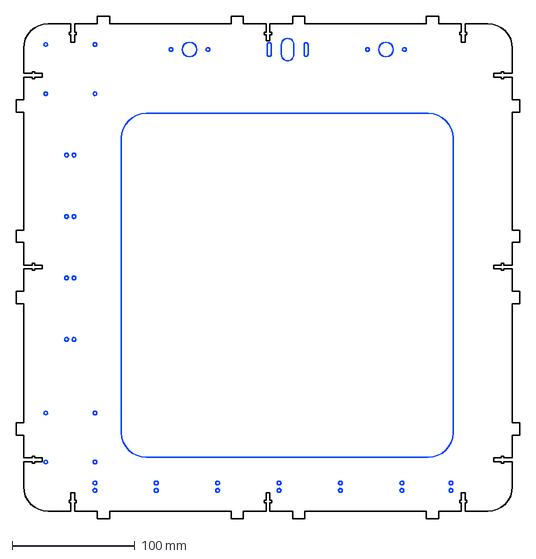
[picture p44: CAD file, 2021-01-02]
dxf/blocks/6mm_les_izrez_gor - LM8UU.dxf
410.0 x 409.0 mm
