Mambix/TroublemakerMX/dxf/blocks/6mm_les_izrez_table_holder.dxf

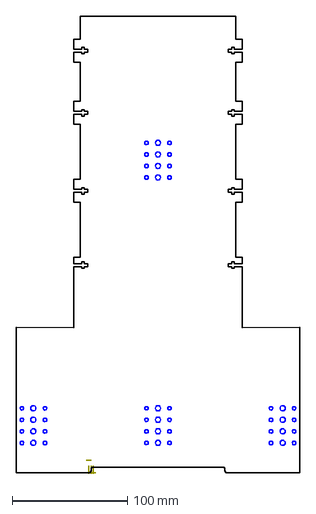
[picture p45: CAD file, 2021-01-02]
dxf/blocks/6mm_les_izrez_table_holder.dxf
246.0 x 397.0 mm
