Mambix/TroublemakerMX/dxf/blocks/6mm_les_izrez_miza.dxf

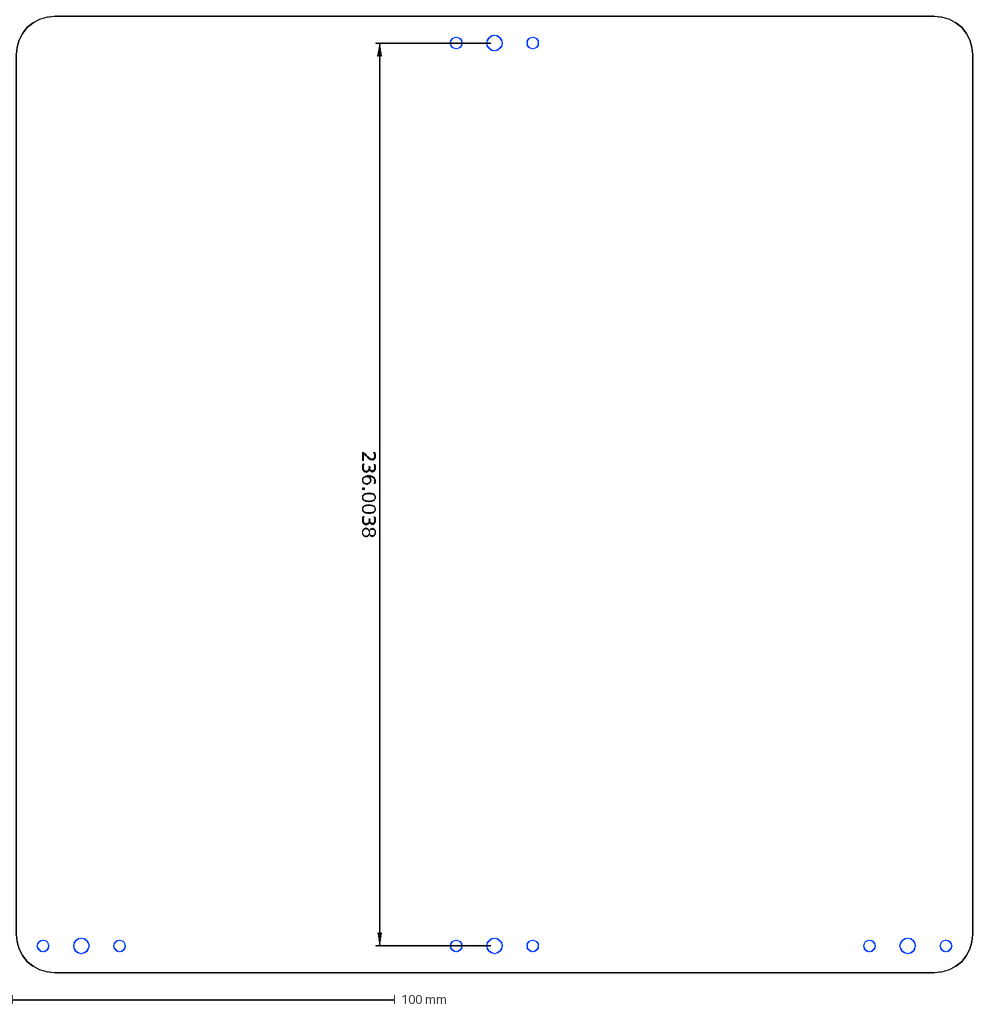
[picture p46: CAD file, 2021-01-02]
dxf/blocks/6mm_les_izrez_miza.dxf
236.0038
