Mambix/TroublemakerMX/stl/Motor_NEMA17.stl

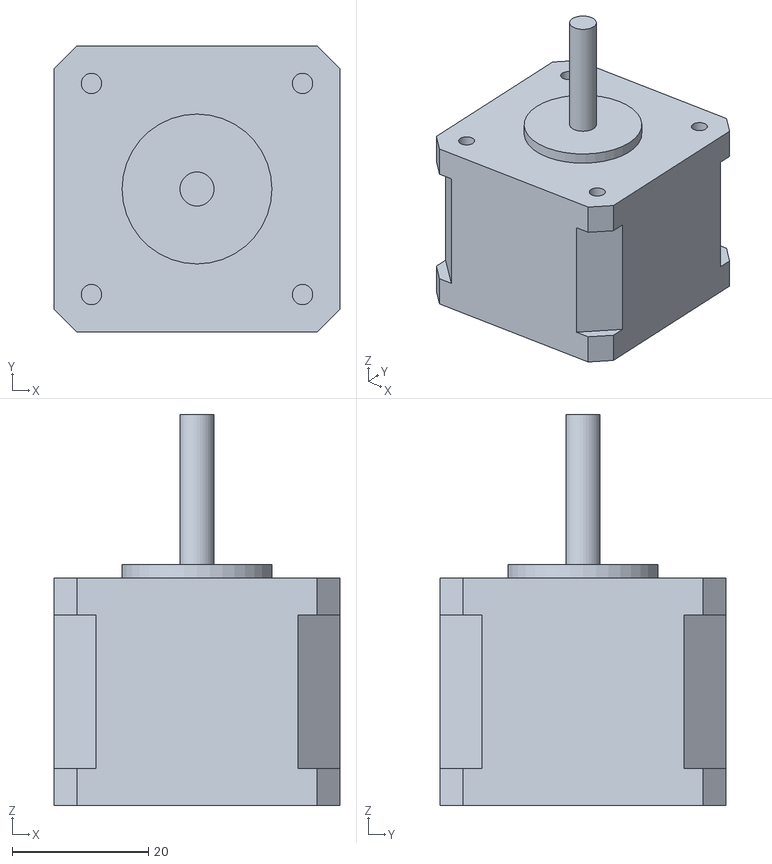
[picture p48: CAD file, 2017-03-04]
stl/Motor_NEMA17.stl
42.0 x 42.0 x 57.4
