Mambix/TroublemakerMX/dxf/blocks/6mm_les_izrez_spredaj - LM8UU.dxf

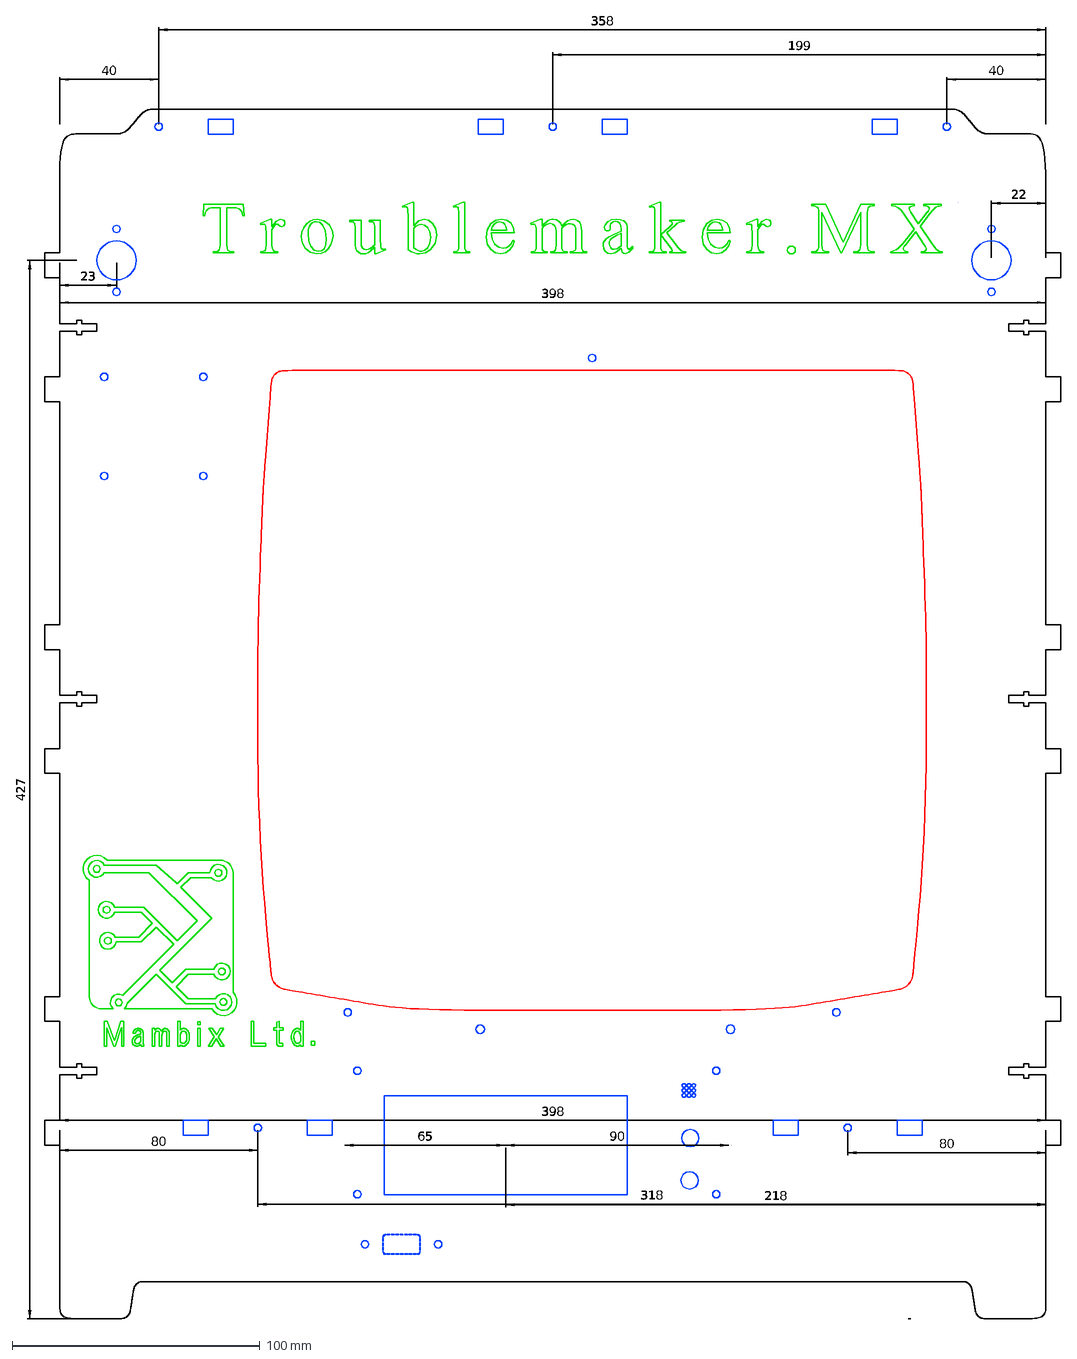
[picture p49: CAD file, 2021-01-02]
dxf/blocks/6mm_les_izrez_spredaj - LM8UU.dxf
398
40
358
199
218
65
90
427
23
80
318
22
