Mambix/TroublemakerMX/stl/Carriage - Connector.stl

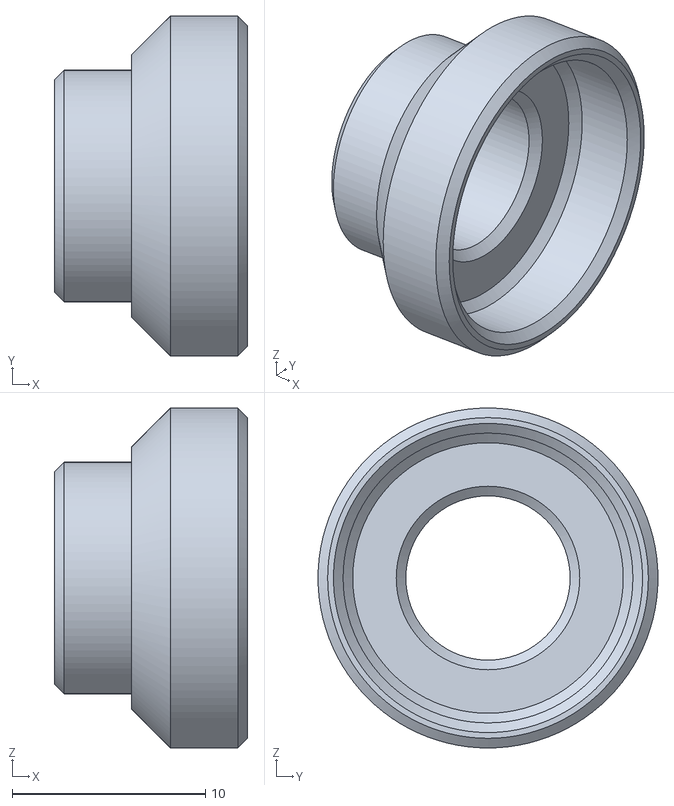
[picture p50: CAD file, 2017-02-22]
stl/Carriage - Connector.stl
10.0 x 17.6 x 17.6
