Mambix/TroublemakerMX/dxf/blocks/6mm_les_izrez_hotend_top.dxf

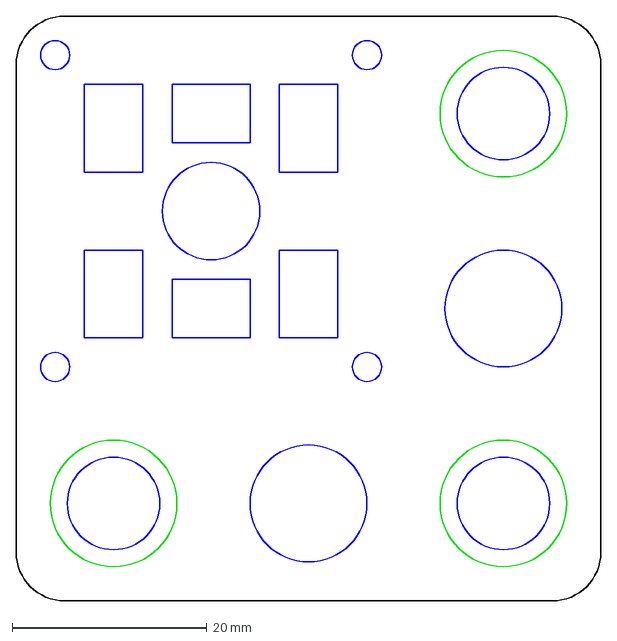
[picture p51: CAD file, 2017-03-04]
dxf/blocks/6mm_les_izrez_hotend_top.dxf
60.0 x 60.0 mm
