Mambix/TroublemakerMX/stl/Carriage - MIDDLE.stl

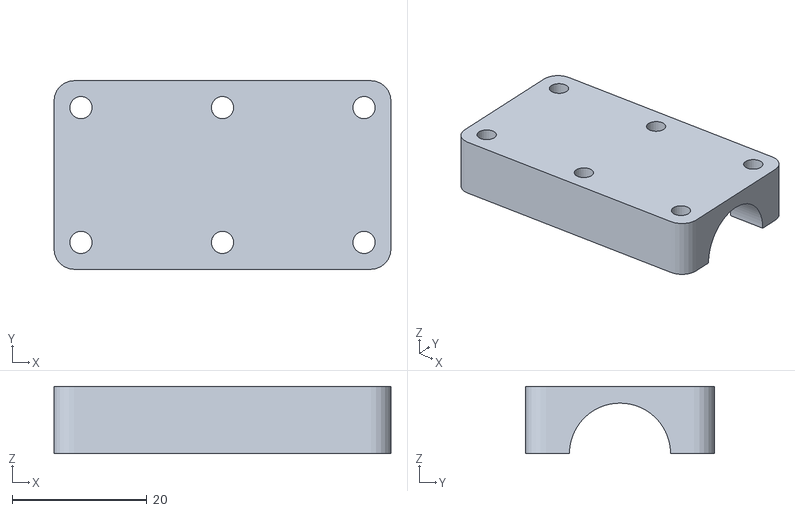
[picture p52: CAD file, 2017-02-22]
stl/Carriage - MIDDLE.stl
50.0 x 28.0 x 10.0
