Mambix/TroublemakerMX/dxf/blocks/6mm_les_izrez_hotend_side_8.dxf

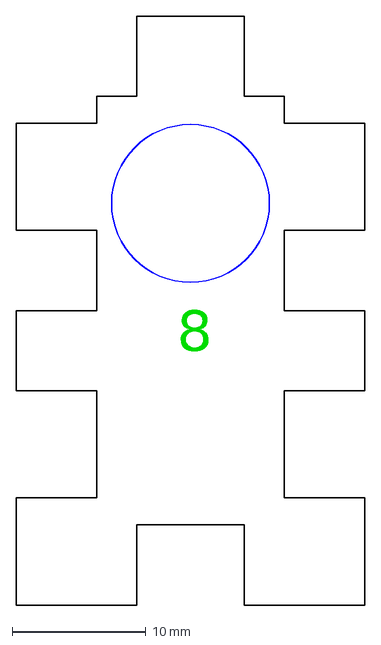
[picture p53: CAD file, 2017-03-04]
dxf/blocks/6mm_les_izrez_hotend_side_8.dxf
8
