Mambix/TroublemakerMX/stl/Carriage - BOTTOM.stl

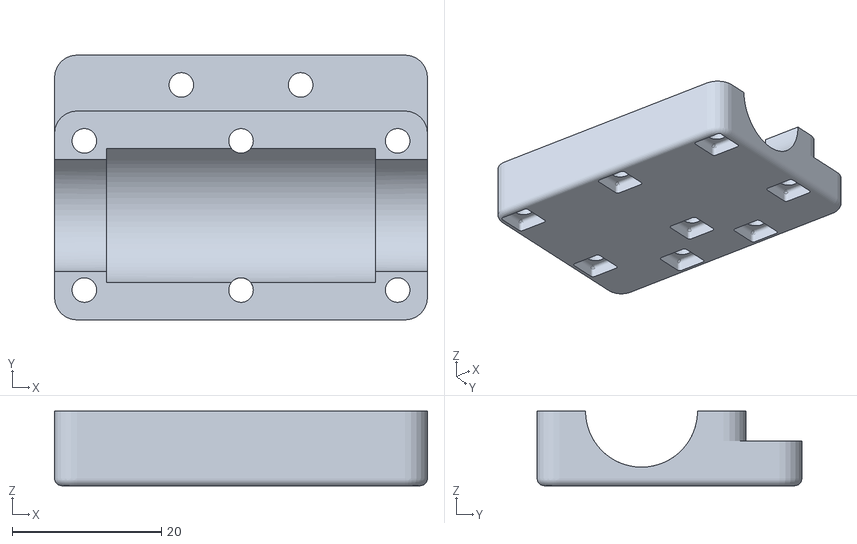
[picture p54: CAD file, 2017-02-22]
stl/Carriage - BOTTOM.stl
50.0 x 35.5 x 10.0
