Mambix/TroublemakerMX/dxf/blocks/HotEnd holder.dxf

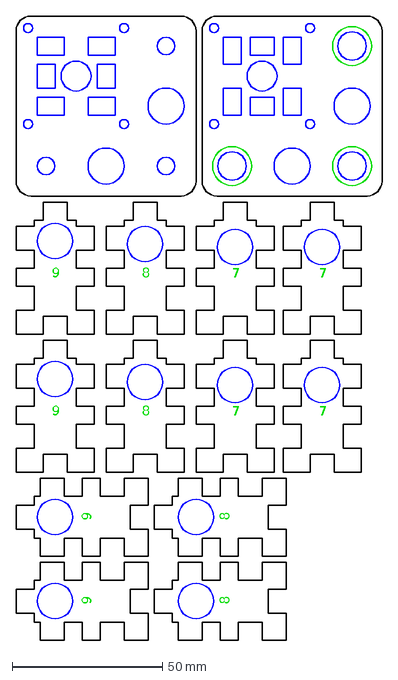
[picture p55: CAD file, 2017-02-22]
dxf/blocks/HotEnd holder.dxf
9
8
7
