Mambix/TroublemakerMX/stl/Carriage - TOP.stl

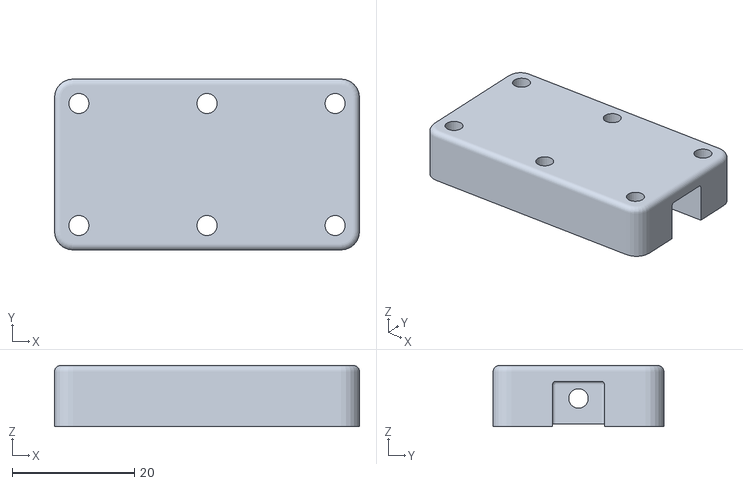
[picture p56: CAD file, 2017-02-22]
stl/Carriage - TOP.stl
50.0 x 28.0 x 10.0
