Mambix/TroublemakerMX/stl/Carriage - MIDDLE #2.stl

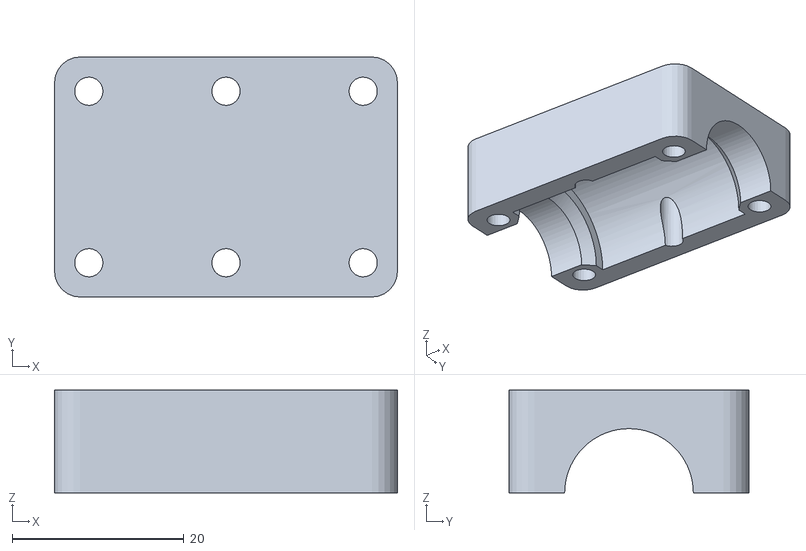
[picture p57: CAD file, 2017-02-22]
stl/Carriage - MIDDLE #2.stl
40.0 x 28.0 x 12.0
