Mambix/TroublemakerMX/stl/Carriage - Support BOTTOM.stl

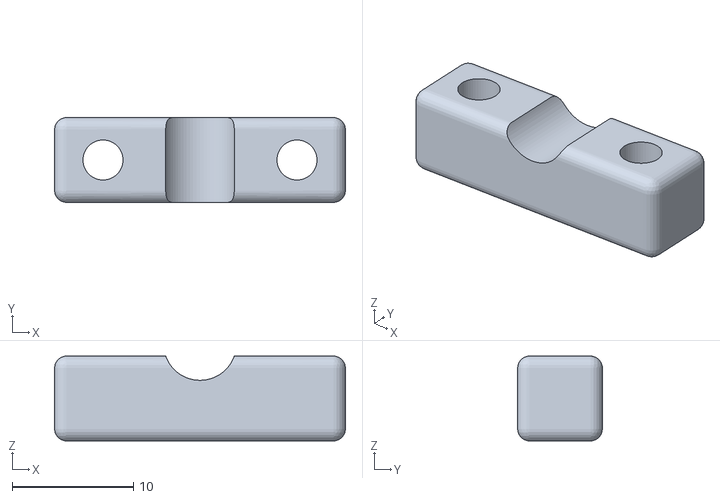
[picture p58: CAD file, 2017-02-22]
stl/Carriage - Support BOTTOM.stl
24.0 x 7.00 x 7.00
