Mambix/TroublemakerMX/stl/Carriage - TOP #2.stl

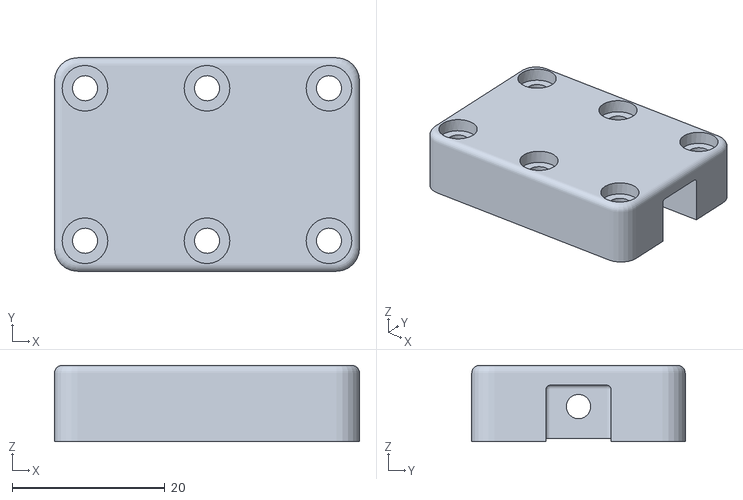
[picture p59: CAD file, 2017-02-22]
stl/Carriage - TOP #2.stl
40.0 x 28.0 x 10.0
