Mambix/TroublemakerMX/stl/Carriage - Support TOP.stl

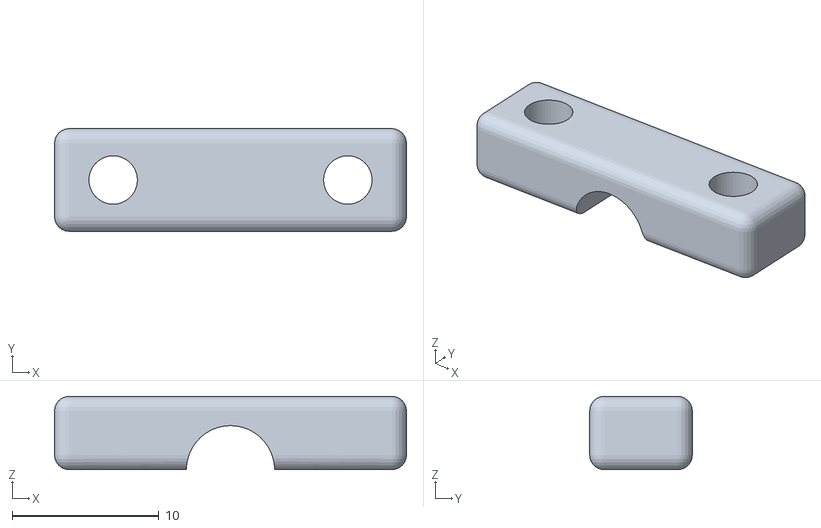
[picture p60: CAD file, 2017-02-22]
stl/Carriage - Support TOP.stl
24.0 x 7.00 x 5.00
