Mambix/TroublemakerMX/stl/Carriage - BOTTOM #2.stl

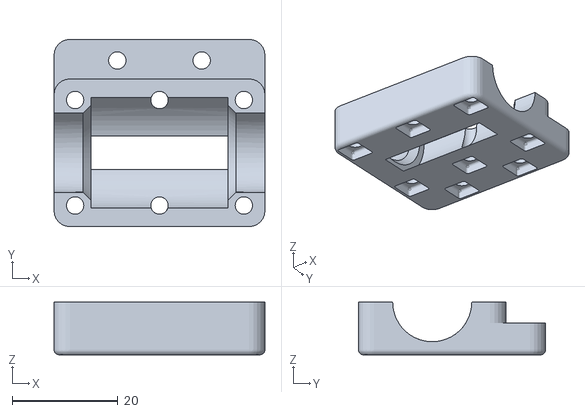
[picture p61: CAD file, 2017-02-22]
stl/Carriage - BOTTOM #2.stl
40.0 x 35.5 x 10.0
