Mambix/TroublemakerMX/stl/GripPart.STL

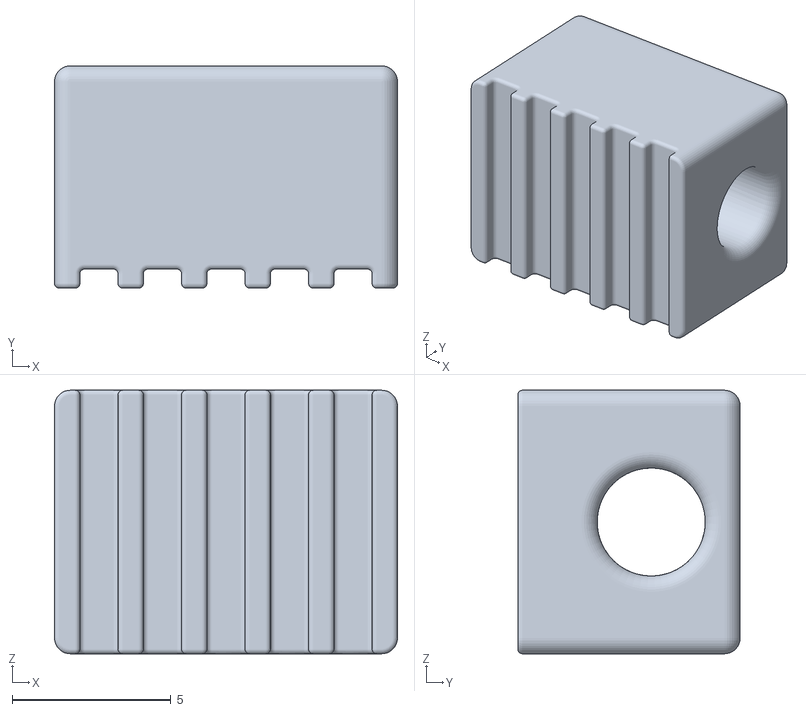
[picture p62: CAD file, 2015-05-01]
stl/GripPart.STL
10.8 x 7.00 x 8.30
