Mambix/TroublemakerMX/stl/LM8UU Bottom.stl

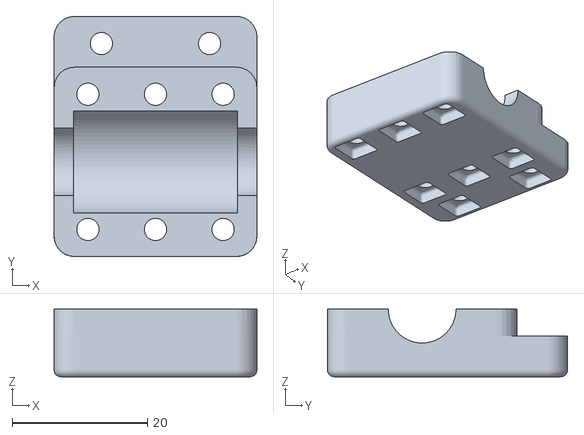
[picture p63: CAD file, 2015-04-25]
stl/LM8UU Bottom.stl
30.0 x 35.5 x 10.0
