Mambix/TroublemakerMX/stl/LM8UU Middle.stl

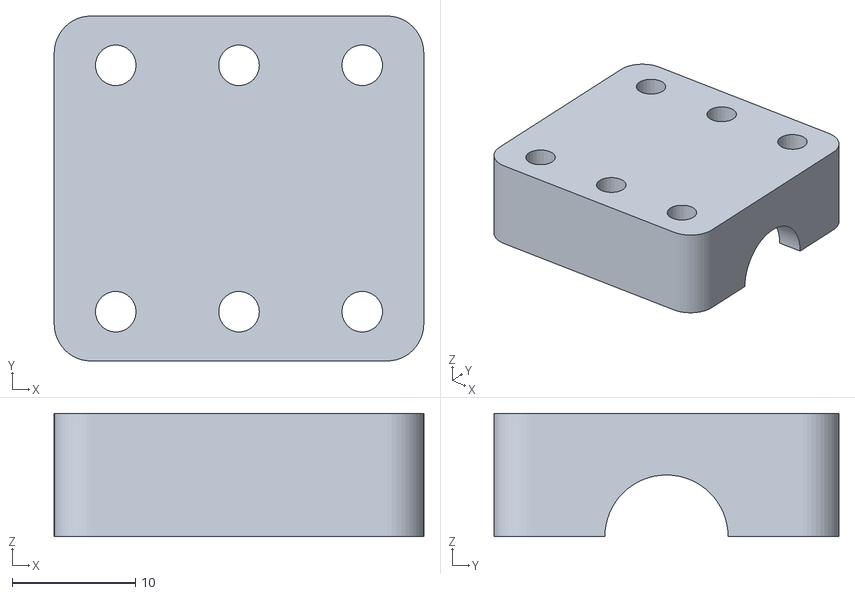
[picture p64: CAD file, 2015-04-19]
stl/LM8UU Middle.stl
30.0 x 28.0 x 10.0
