Mambix/TroublemakerMX/stl/LM8UU Support Bottom.stl

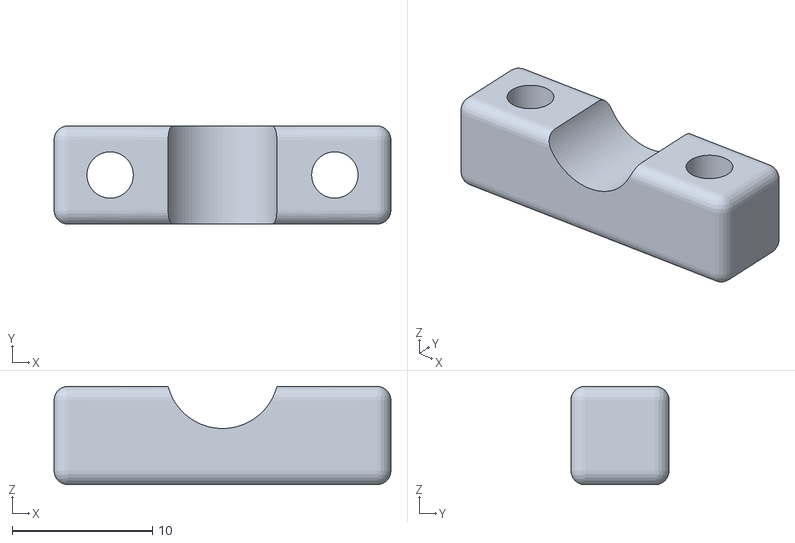
[picture p65: CAD file, 2015-04-19]
stl/LM8UU Support Bottom.stl
24.0 x 7.00 x 7.00
