Mambix/TroublemakerMX/stl/LM8UU Support Top.stl

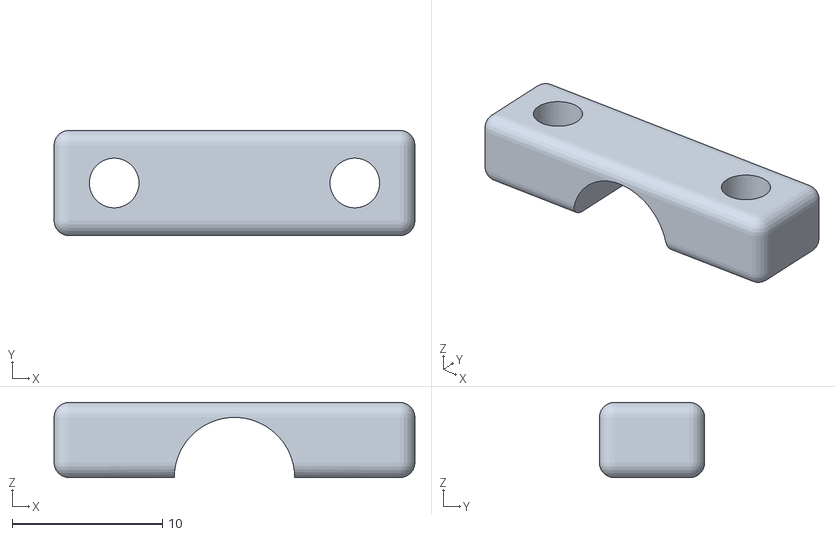
[picture p66: CAD file, 2015-04-19]
stl/LM8UU Support Top.stl
24.0 x 7.00 x 5.00
