Mambix/TroublemakerMX/stl/UltimakerPlexiHandle.stl

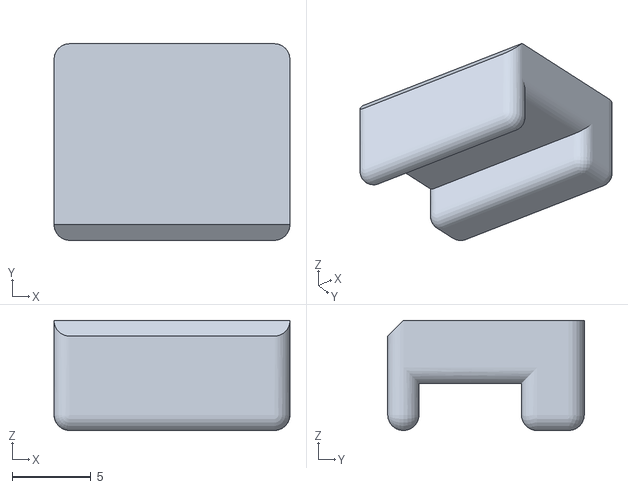
[picture p67: CAD file, 2015-04-15]
stl/UltimakerPlexiHandle.stl
15.0 x 12.5 x 7.00
