Mambix/TroublemakerMX/stl/UltimakerPlexiMount.stl

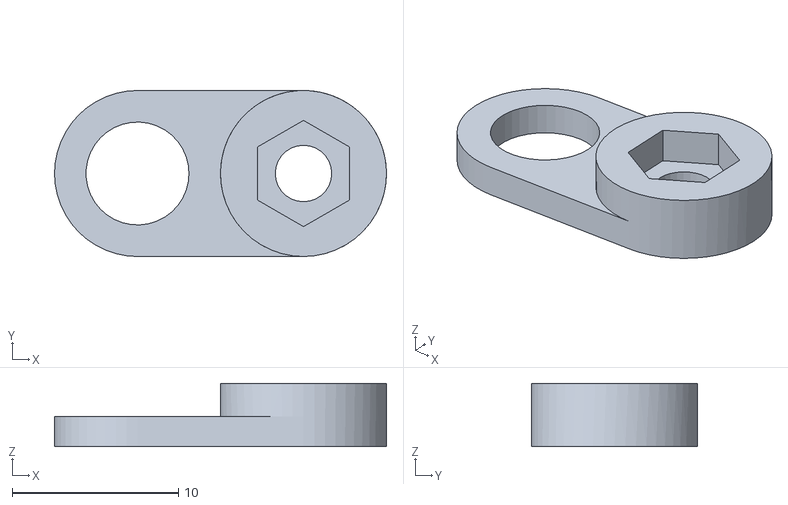
[picture p68: CAD file, 2015-04-15]
stl/UltimakerPlexiMount.stl
20.0 x 10.0 x 3.80
