Mambix/TroublemakerMX/(list of files, cad)

Other CAD files:
dxf/Building blocks.dxf
stl/Carrige #2 - 180.stl
stl/GOR.stl
stl/movedHE_FRONT.stl
stl/movedHE_LEFT.stl
stl/movedHE_BACK.stl
stl/HE_BACK.stl
stl/HE_LEFT.stl
stl/HE_FRONT.stl
stl/LM8UU Top.stl
FreeCAD/Nut holder.FCStd
stl/Nut Holder.stl
