Mambix/TroublemakerMX/(threads)

Thread 1 (2015-04-24):

Modify Troublemaker dimensions and parts

Mambix, 2015-04-24:
- [ ] FRONT panel
 - [ ] Widen the panel left 5cm, 2cm right
 - [ ] Move holes for bearings up by 5cm
 - [ ] Move holes for end switches; modify them for SW?
- [ ] LEFT panel
 - [ ] Widen the panel right (front of the printer) by 4cm
 - [ ] Move holes for bearings up 5cm;
 - [ ] right bearing must go right by 4cm
 - [ ] left bearing must go right by 0.5cm (because of wider carriage)
 - [ ] Move holes for motor mount; allow for more travel
 - [ ] Move holes for switches; modify them for SW1
- [ ] RIGHT panel
 - [ ] Move holes for bearings up 5cm;
 - [ ] right bearing must go right by 4cm
 - [ ] left bearing must go right by 0.5cm (because of wider carriage)
 - [ ] Move holes for motor mount; allow for more travel
 - [ ] Move holes for switches; modify them for SW1
- [ ] BACK panel
 - [ ] Move holes for bearings up 5cm;
 - [ ] right bearing must go right by 4cm
 - [ ] left bearing must go right by 0.5cm (because of wider carriage)
 - [ ] Move holes for motor mount; allow for more travel
 - [ ] Move holes for switches; modify them for SW1
 - [ ] Holes for components: Extruder, Motor electronics, Switches
- [ ] TOP panel (Hole size stays the same)
 - [ ] expand left by 5cm
 - [ ] expand right by 2cm
 - [ ] expand front by 4cm
- [ ] BOTTOM panel
 - [ ] expand left by 5cm
 - [ ] expand right by 2cm
 - [ ] expand front by 4cm
 - [ ] new holes for components: PSU; power board; rPI
 - [ ] new holes for wires
- [ ] LM8UU carriages
- [ ] top/bottom
- [ ] front LCD opening
- [ ] Motor electronics

Mambix, 2016-08-01:
ball-bearing hole size 16.02mm

Thread 2 (2015-04-24):

Fix LM8UU carriage botom plate

Mambix, 2015-04-24:
Wall is to thin
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

Mambix, 2015-04-25:
Fixed; increased width by 0.5mm

Closed 2015-04-25.

Thread 3 (2015-04-24):

Write gcode interpreter in python

Mambix, 2015-04-24:
octoprint sends gcode commands to serial port.
external USB to TTL sends this to serial port were python code will capture it and send it to electronics.

- [ ] gCode interpreter
- [ ] read sensors
- [ ] control motors
- [ ] LCD controll

Mambix, 2015-06-13:
Decided to use ArduinoMega2560 and Marlin software instead: https://github.com/Mambix/Marlin

Closed 2015-06-13.

Thread 10 (2015-06-13):

make sure LM8UU carriage have enough clearance

Mambix, 2015-06-13:

Mambix, 2015-06-13:
Z-axis rods are 27mm away from back wall
Carriage is 28.5mm away from wall

Closed 2015-06-13.

Thread 8 (2015-06-13):

Draw new mounting holes

Mambix, 2015-06-13:
- [ ] rPi B+
- [ ] 24V/10A PSU
- [ ] Arduino Mega 2560
- [ ] Max31855
- [ ] 5V USB PSU

Mambix, 2015-10-03:
- [ ] HDMI
- [ ] USB
- [ ] Network

Thread 11 (2015-06-19):

Design PCB for switches

Mambix, 2015-06-19:
Since switches only come with 50cm of wire they should be connected to a 5cmx5cm board close to the top of the printer. Another pair of wires will connect correct signals to the arduino mega board.

Thread 12 (2015-06-19):

new PCB for LCD

Mambix, 2015-06-19:
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

Needs to be modified so that it contains MAX31855 chips for reading temperature of extruder heads.
It also needs just an additional header to connect external MAX31855 board if needed.

Make it an opensource design with new altium circuit maker

Mambix, 2017-01-11:
one option is to connect it as SD card?

Thread 13 (2015-06-19):

Use eInk screen

Mambix, 2015-06-19:
Use 6" eInk display for displaying information. Would be nice to use a touch screen version to replace the keyys/rotary switch

Thread 14 (2015-06-20):

Fix holes for ball berigns to 16mm

Mambix, 2015-06-20:
Holes should be 16mm, or maybe even 15.98mm

- [x] Front
- [x] Left
- [x] Right
- [x] Back

Closed 2015-06-20.

Thread 15 (2015-06-20):

Fix holes

Mambix, 2015-06-20:
Plywood
- [x] Front
- [x] Back
- [x] Left
- [x] Right
- [x] Top
- [x] Bottom

Screw:
- [x] Front
- [x] Back
- [x] Top
- [x] Bottom

Closed 2015-06-20.

Thread 17 (2015-06-20):

Fix design for new LCD

Mambix, 2015-06-20:

Mambix, 2015-06-20:
Found gerber files online so should be spot on

Closed 2015-06-20.

Thread 21 (2015-06-21):

Make a wooden hotend holder

Mambix, 2015-06-21:
Based on LM8UU

http://www.cnccat.com/products_img/images/LM_main_dimensions.jpg

Mambix, 2015-10-06:
Finished; need to be cut out and tested

Closed 2015-10-06.

Thread 22 (2015-09-09):

Make a wooden carriages

Mambix, 2015-09-09:
Make wooden carriages for LM8UU bearings

Mambix, 2015-09-20:
http://www.goodluckbuy.com/images/detailed_images2/org_image/20110328120256_.jpg

Mambix, 2015-10-06:
Would need a separate mechanism for belt drive in this case.

Closed 2015-10-06.

Thread 24 (2015-09-20):

PCB for temp sensors

Mambix, 2015-09-20:
MAX31855 via SD card port on LCD board?
aka. The RepRapDiscount Smart Controller (white PCB)

Mambix, 2016-08-04:
or: http://www.aliexpress.com/store/product/Newest-Product-u-SD-breakout-board-For-exporting-UART-and-JTAG-pins-of-Cubieboard-Free-Shipping/1149129_2001110445.html

Mambix, 2016-08-04:
http://www.digikey.com/product-detail/en/segger-microcontroller-systems/6.20.13-SD-CARD-ADAPTER/899-1020-ND/4476090

Mambix, 2016-08-04:
http://www.digikey.com/product-detail/en/sparkfun-electronics/TOL-09419/1568-1041-ND/5140806

Mambix, 2016-08-04:
http://www.digikey.com/product-detail/en/sparkfun-electronics/TOL-11468/1568-1021-ND/5140786

Thread 25 (2015-09-20):

Fix ball-bearing sizes

Mambix, 2015-09-20:
Should be 16.02mm

Mambix, 2015-09-20:
Already fixed!!!

https://github.com/Mambix/TroublemakerMX/issues/14

Closed 2015-09-20.

Thread 26 (2015-09-30):

Power distribution board (PCB)

Mambix, 2015-09-30:

Mambix, 2015-11-19:
KIS3R33 module for +5V and USB (with switch) for powering rPI
http://www.ebay.com/itm/10pcs-MP2307-DC-DC-step-down-power-supply-KIS-3R33s-module-I-P-4-75-23V-3A-95-/281761150378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

Mambix, 2016-08-06:
https://workspace.circuitmaker.com/Projects/Details/MambiX/Power-Distribution-board

Closed 2016-08-06.

Thread 27 (2015-11-04):

Fix wooden hotends

Mambix, 2015-11-04:
Fixes based on test cuts

Closed 2015-11-15.

Thread 29 (2015-11-04):

Fix holes for RJ45, HDMI, USB

Mambix, 2015-11-04:

Closed 2015-11-15.

Thread 31 (2017-02-20):

create 3D model

Mambix, 2017-02-20:
https://github.com/mozman/ezdxf

Mambix, 2017-02-21:
writing STL files: https://pypi.python.org/pypi/numpy-stl

Mambix, 2017-02-21:
https://en.wikipedia.org/wiki/Rotation_matrix

Mambix, 2017-02-21:
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

Mambix, 2017-02-22:
http://pymesh.readthedocs.io/en/latest/

Mambix, 2017-02-22:
https://pypi.python.org/pypi/trimesh

Mambix, 2017-02-28:
- [ ] DXF's >> Cut files
- [ ] DXF's >> 3D

Mambix, 2017-03-04:
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

Closed 2017-03-04.

Thread 33 (2017-03-04):

Bottom holes not aligned

Mambix, 2017-03-04:
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

Mambix, 2017-03-12:
fixed

Closed 2017-03-12.

Thread 35 (2017-03-12):

Lower carriage rod by 2mm

Mambix, 2017-03-12:
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

Mambix, 2017-03-12:
done,
just needed to flip the parts?

Closed 2017-03-12.

Thread 38 (2017-05-18):

Use 300x200 heated bed

Mambix, 2017-05-18:

Mambix, 2017-11-26:
Or maybe 2x 200x200 as they are cheaper. Need to get custom Alu cover 400x200mm in size to cover both of them.

Thread 39 (2018-01-31):

Remove python scripts and FreeCAD macros

Mambix, 2018-01-31:
And replace them with my new published opensource tools:

- [ ] [CO2 Tools](https://github.com/Mambix/co2tools)
- [ ] [Import files to FreeCAD wirh YAML config files](https://github.com/Mambix/FreeCAD-yaml-workspace)
