Mambix/TroublemakerMX/pdf/4mm_deli.pdf

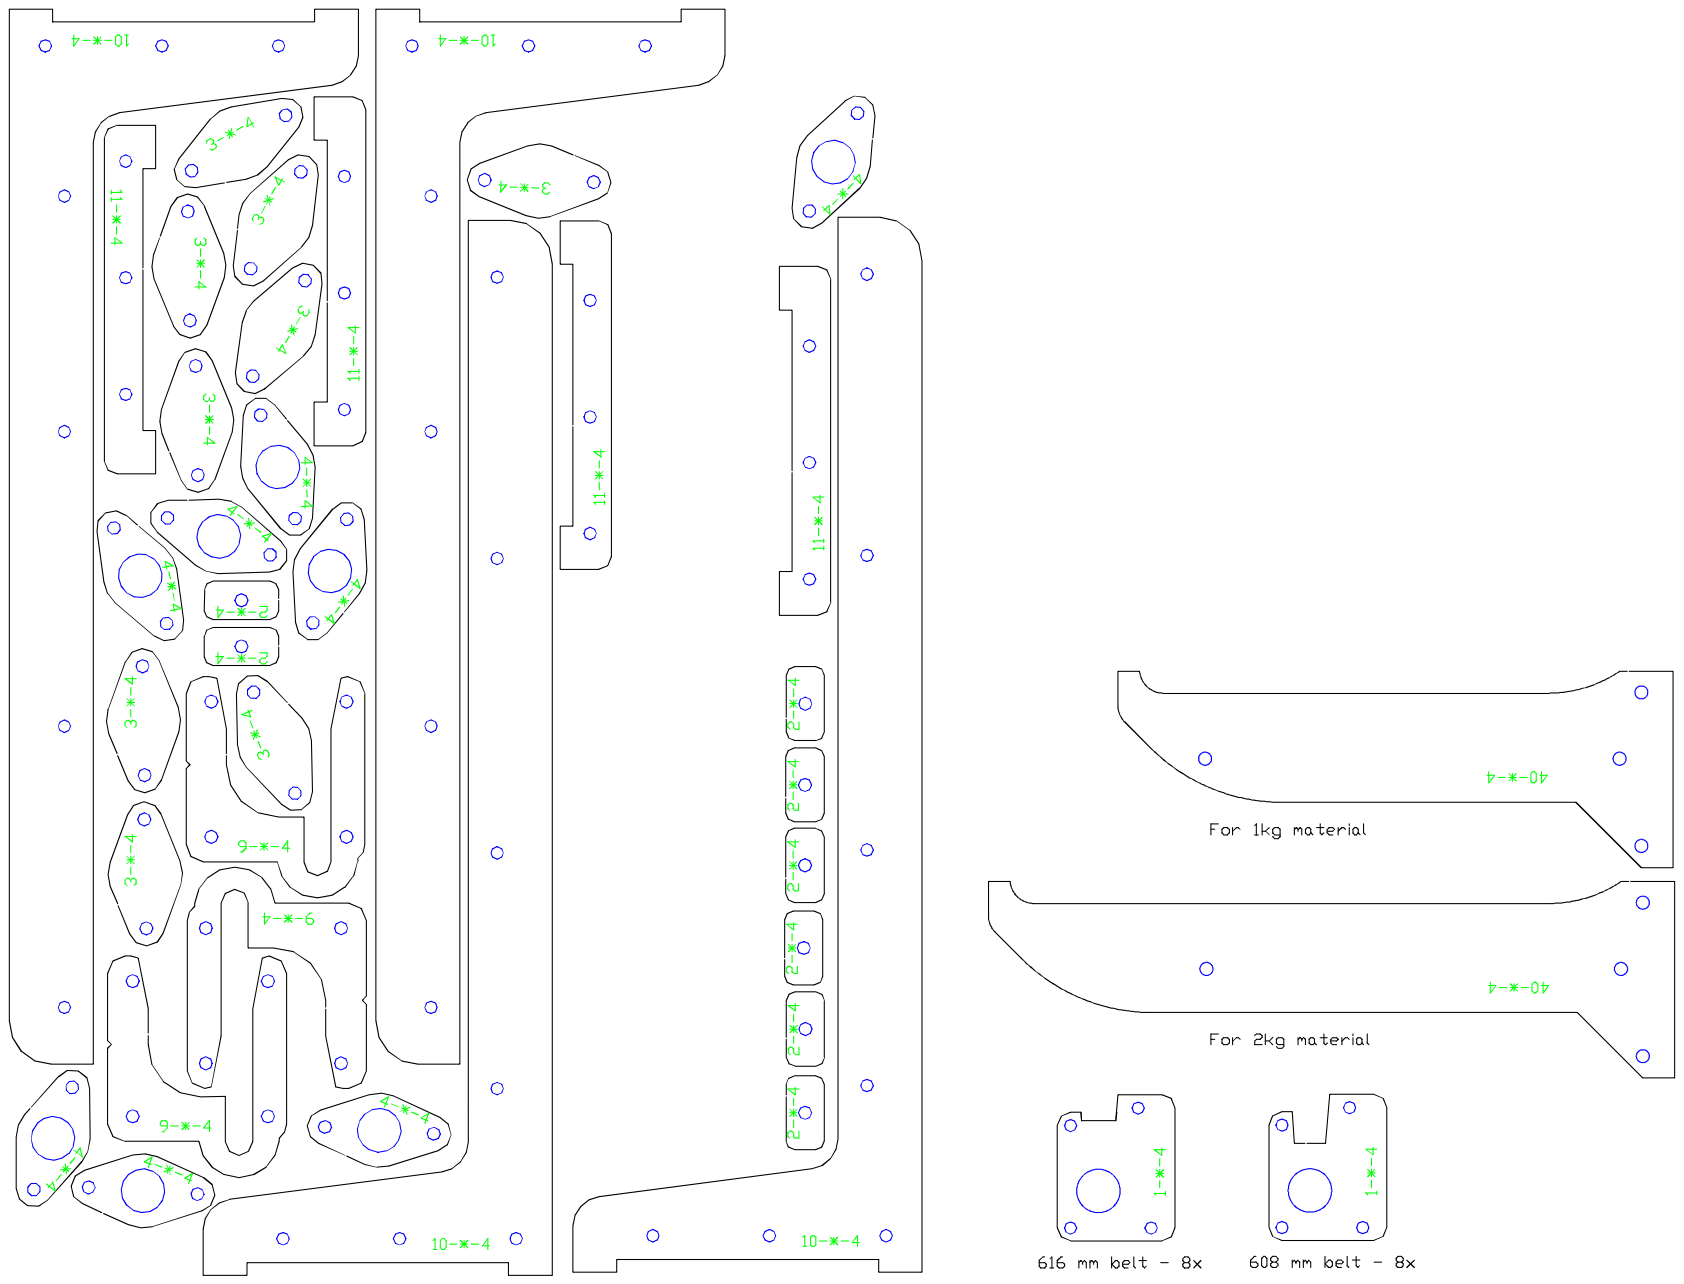
[picture p69: page 1]
