Mambix/TroublemakerMX/pdf/6mm_les_izrez_gor_dol.pdf

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

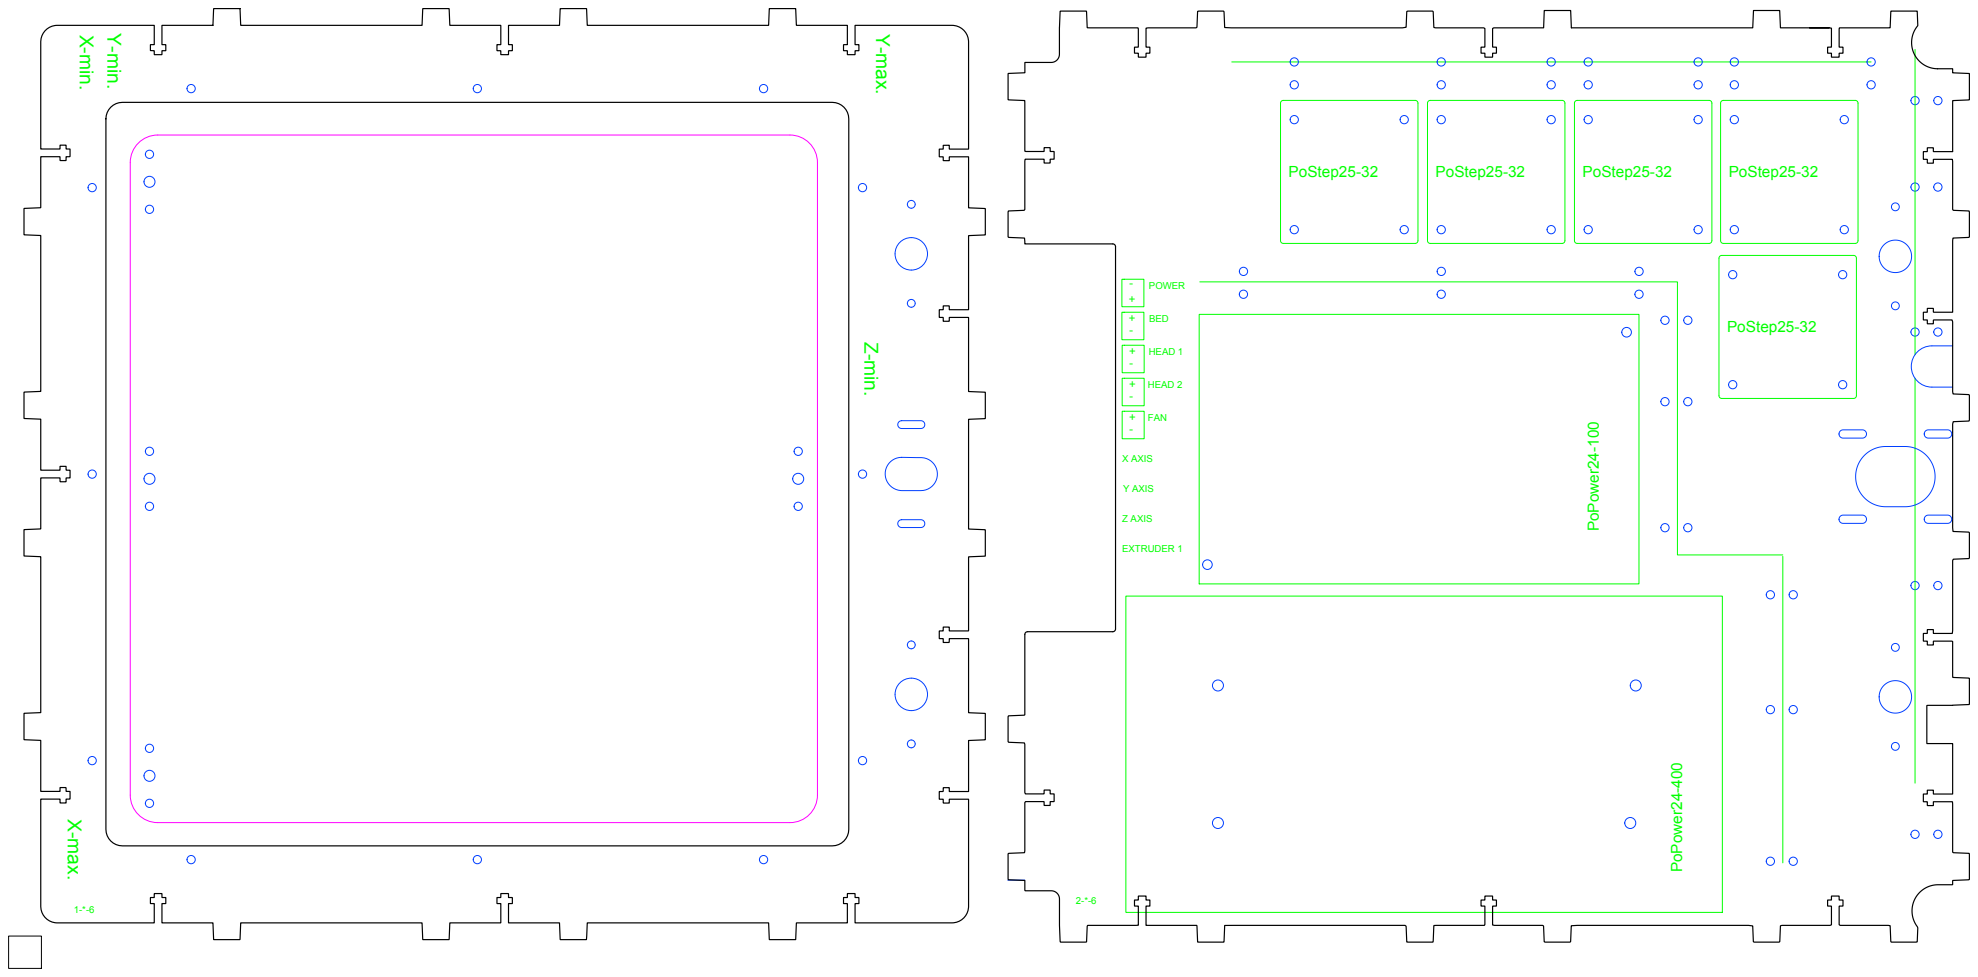
[picture p70: page 1]
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
