Mambix/TroublemakerMX/pdf/6mm_les_izrez_levo_desno.pdf

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

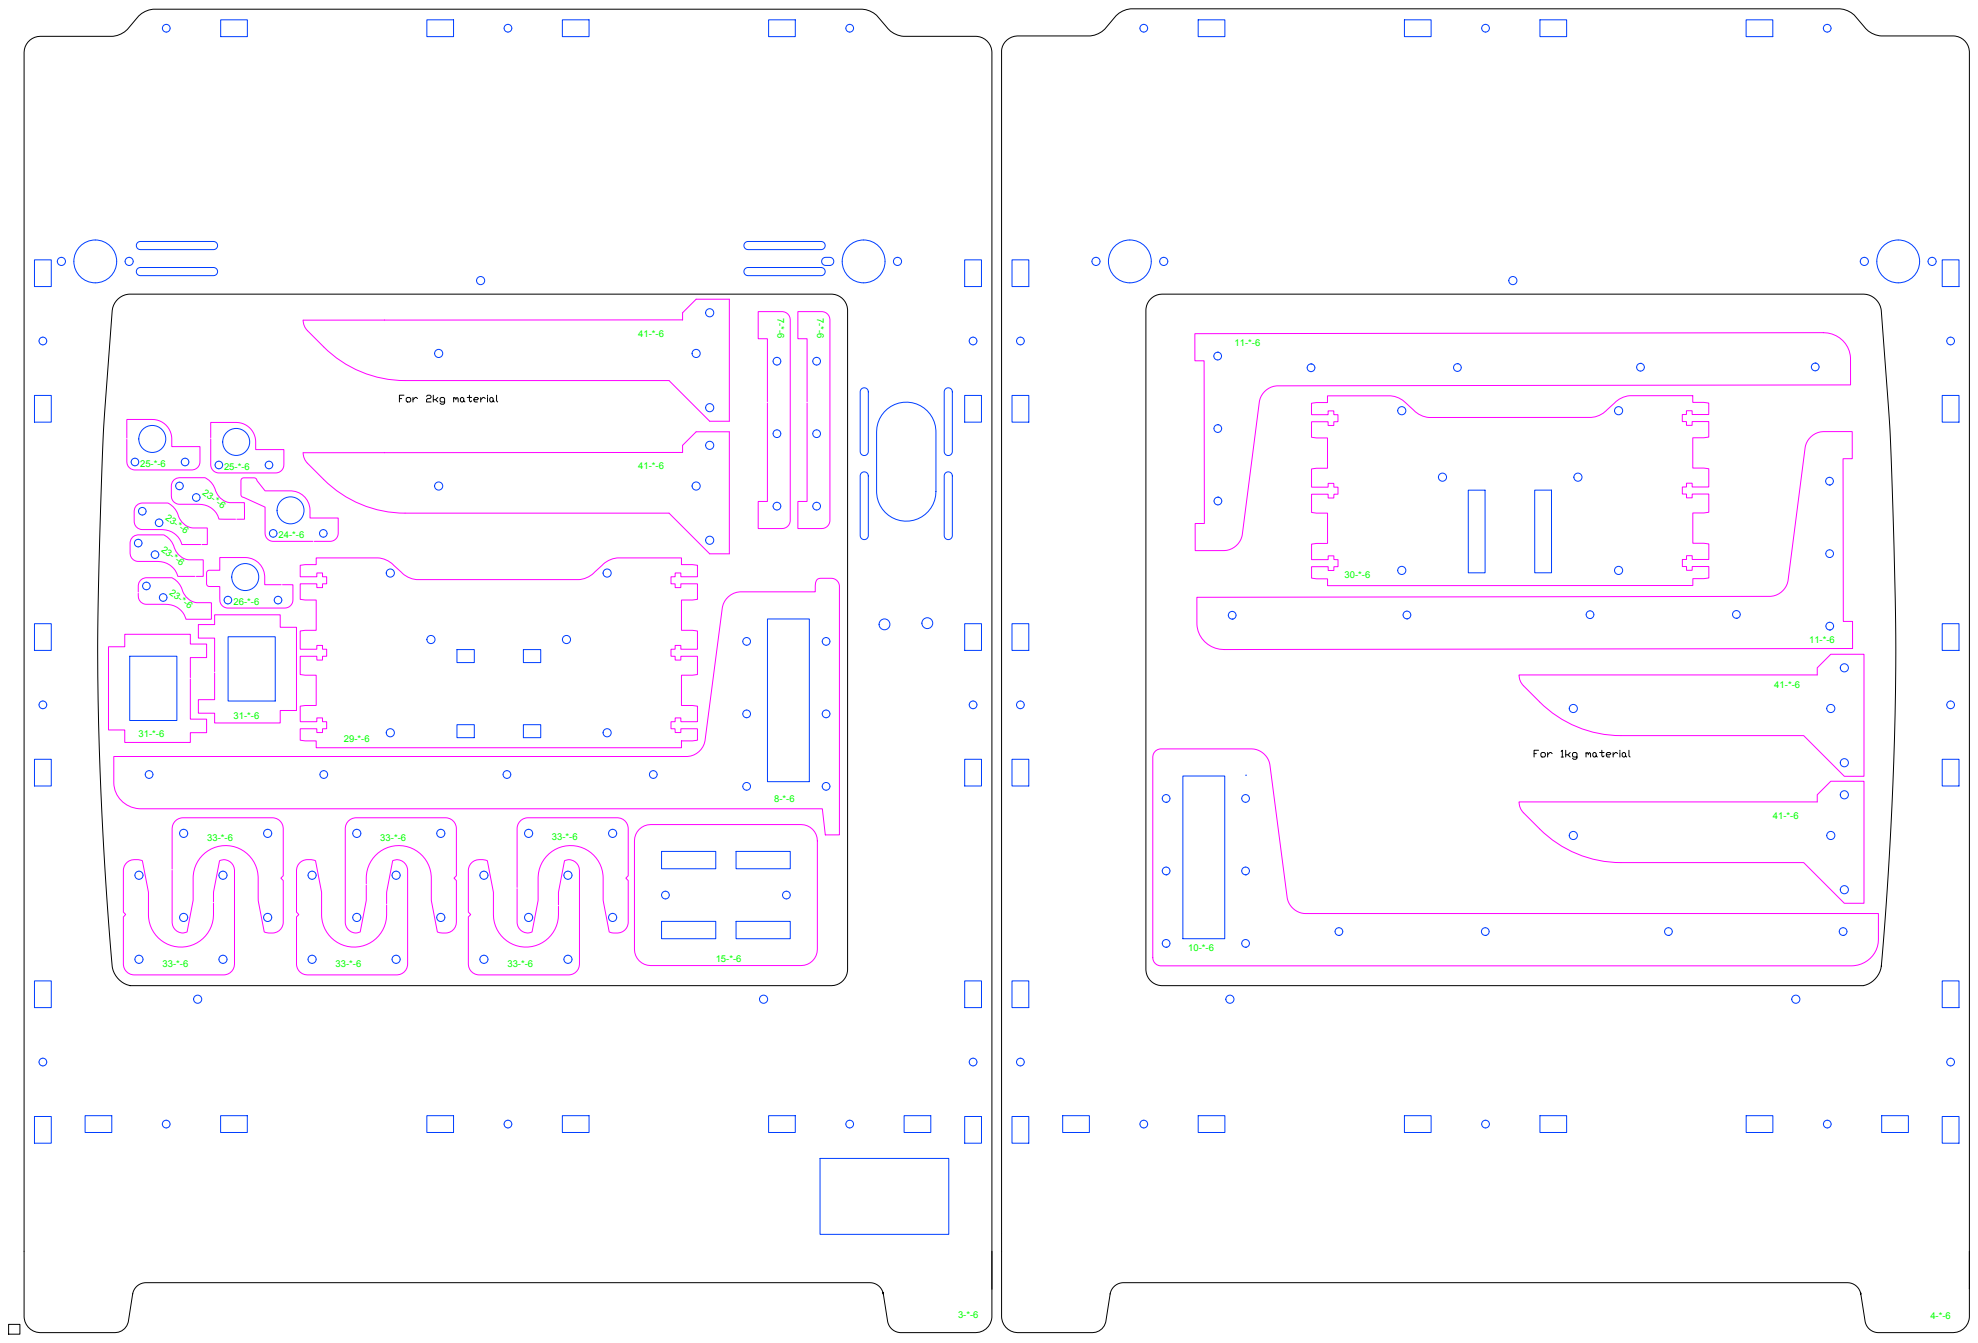
[picture p71: page 1]
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
