Mambix/TroublemakerMX/pdf/6mm_plexi.pdf

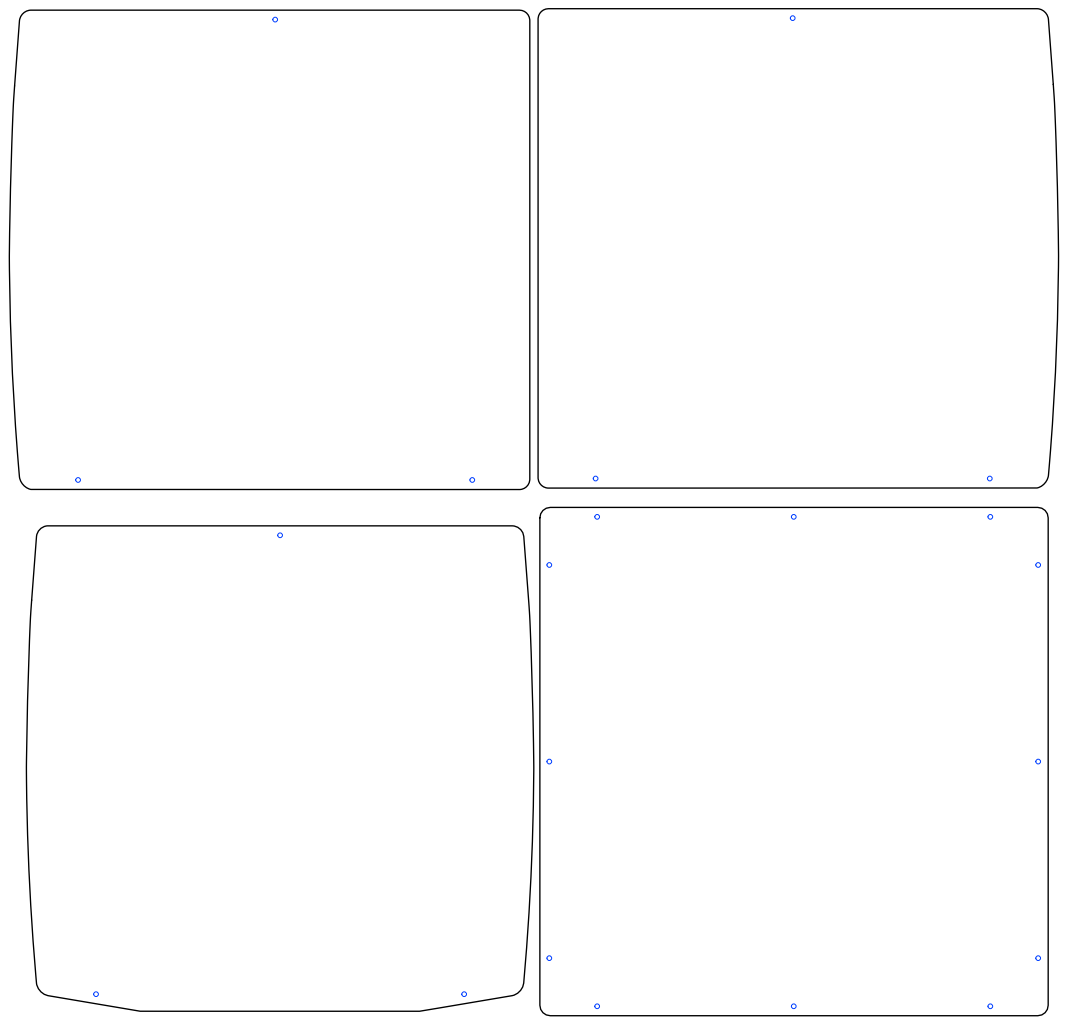
[picture p73: page 1]
