Mambix/TroublemakerMX/pdf/BeltAligner.pdf

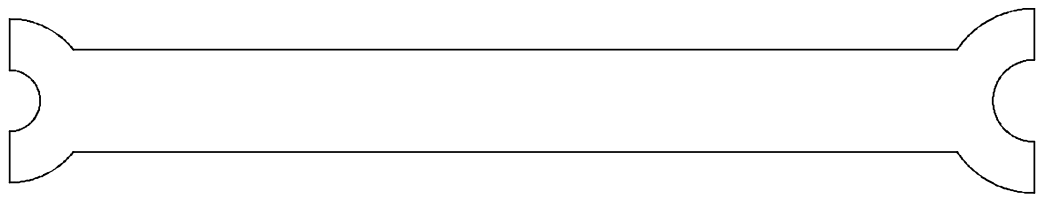
[picture p74: page 1]
