Mambix/TroublemakerMX/pdf/gumb.pdf

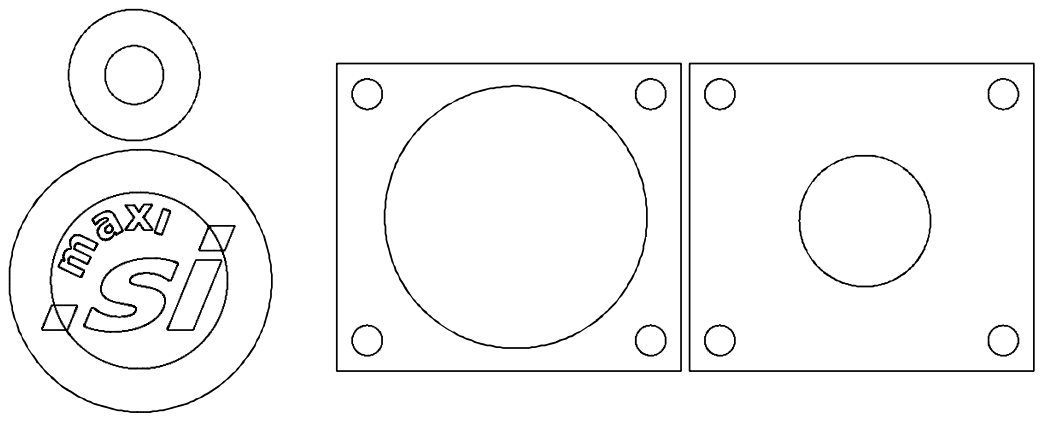
[picture p75: page 1]
