Mambix/TroublemakerMX/pdf/miza.pdf

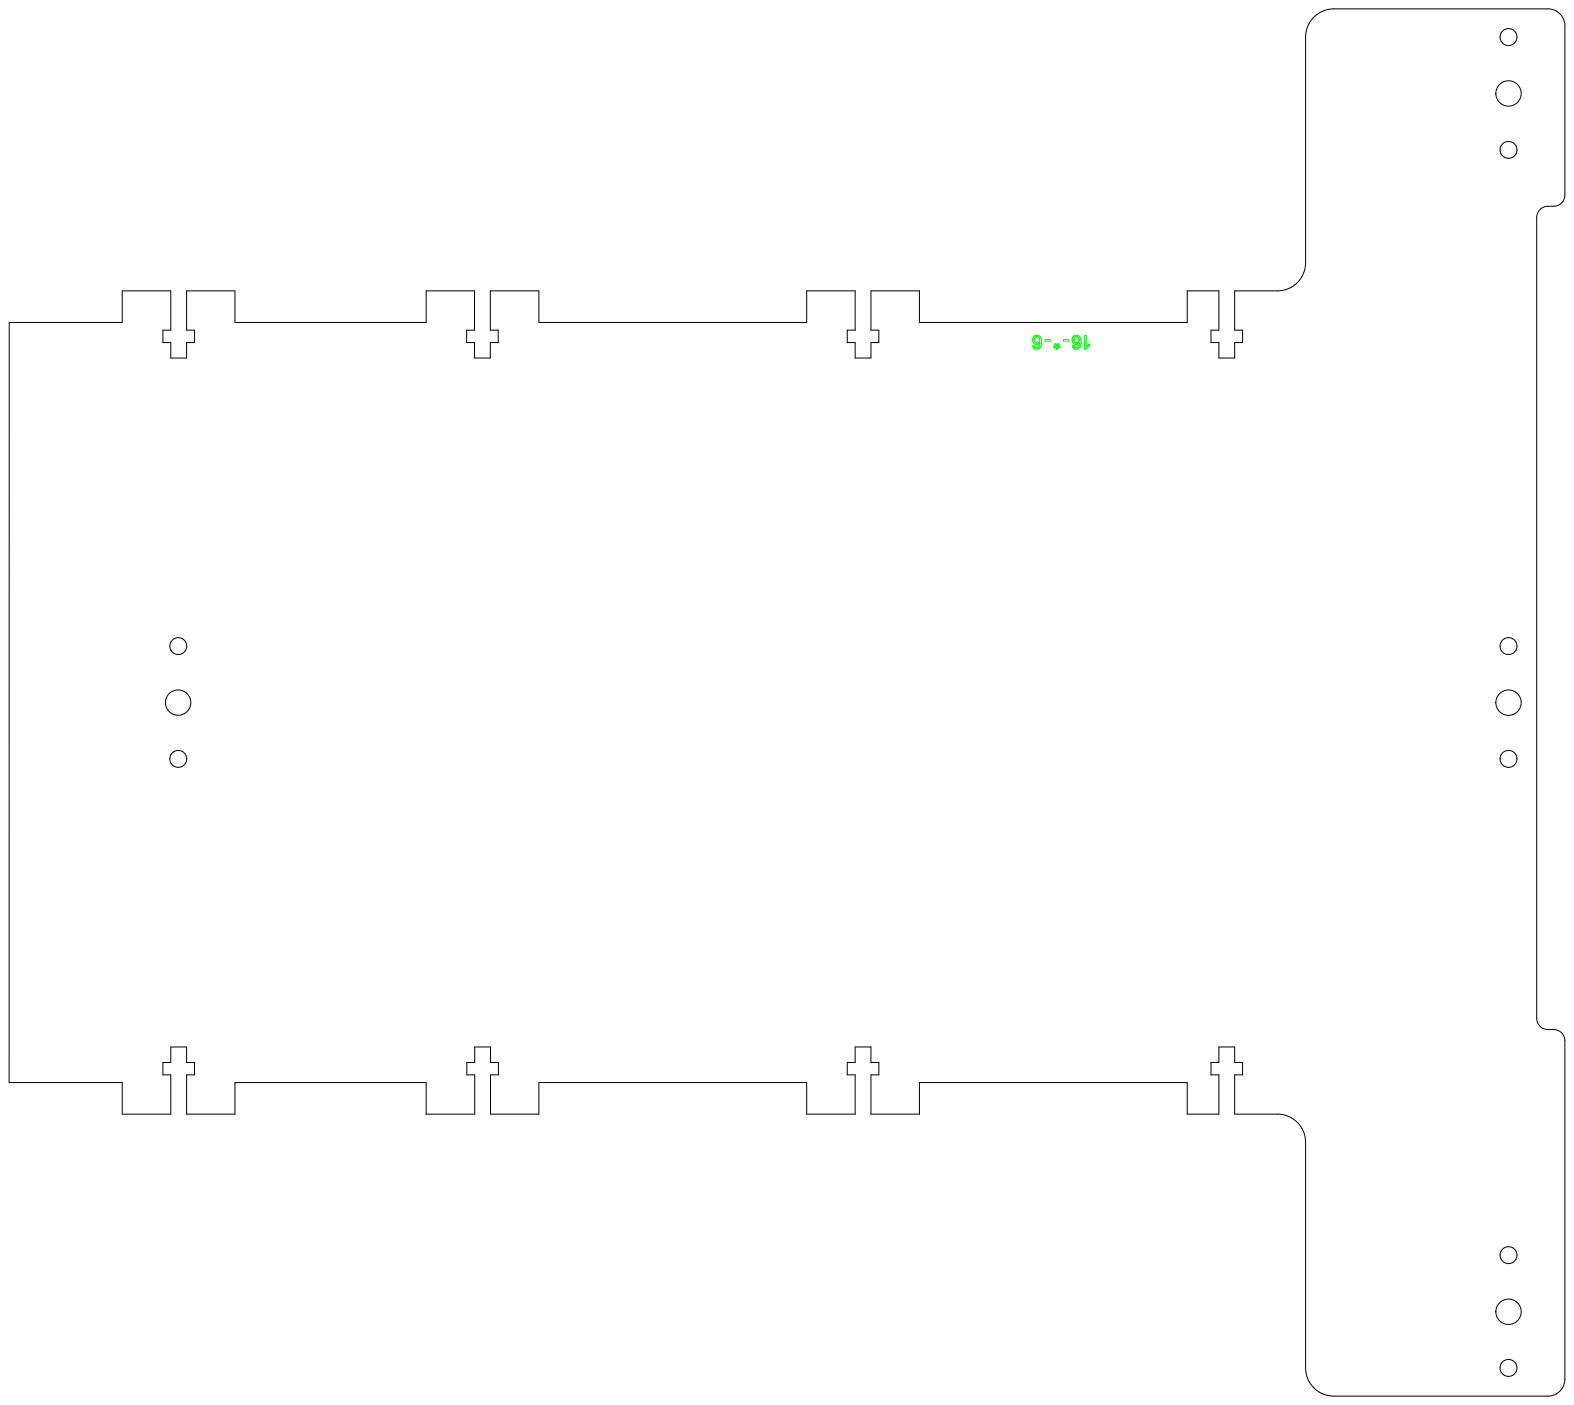
[picture p76: page 1]
