Mambix/TroublemakerMX/(commit log)

2015-04-15 Original Plans for Troublemaker
    [4mm_deli.dwg, 4mm_deli.dxf, 6mm_gravura_prva_stran.dwg, 6mm_gravura_prva_stran.dxf, 6mm_les_izrez_gor_dol.dwg, 6mm_les_izrez_gor_dol.dxf, 6mm_les_izrez_levo_desno.dwg, 6mm_les_izrez_levo_desno.dxf]
2015-04-18 Extended table for 40mm
    [miza.dxf]
2015-04-18 Modified panels; increased width by 60mm
    [6mm_les_izrez_levo_desno.dxf]
2015-04-18 Started working on bulding blocks
    [Building blocks.dxf]
2015-04-19 LM8UU Carrige
    [LM8UU Bottom.stl, LM8UU Carrige.FCStd, LM8UU Middle.stl, LM8UU Support Bottom.stl, LM8UU Support Top.stl, LM8UU Top.stl]
2015-04-19 Ferw fixes
    [6mm_les_izrez_levo_desno.dxf, Building blocks.dxf]
2015-04-19 Started changing front/back side
    [6mm_les_izrez_levo_desno.dxf, 6mm_les_izrez_spredaj_zadaj.dxf, Building blocks.dxf]
2015-04-25 Fixed bottom plate
    [LM8UU Bottom.stl, LM8UU Carrige.FCStd]
2015-04-26 Work on top/bottom plate; added nut holder 3D design
    [6mm_les_izrez_gor_dol.dxf, 6mm_les_izrez_levo_desno.dxf, 6mm_les_izrez_spredaj_zadaj.dxf, Nut Holder.stl, Nut holder.FCStd]
2015-04-26 Updated top/bottom plate
    [6mm_les_izrez_gor_dol.dxf, 6mm_les_izrez_spredaj_zadaj.dxf]
2015-05-01 GripPart from http://www.thingiverse.com/thing:218220; CC license
    [GripPart.STL]
2015-05-30 Adjusted dimensions based on test cut
    [Building blocks.dxf]
2015-06-13 Few fixes to the design: Issue #5 Issue #4
    [6mm_les_izrez_gor_dol.dxf, 6mm_les_izrez_levo_desno.dxf, 6mm_les_izrez_spredaj_zadaj.dxf, Building blocks.dxf]
2015-06-21 Progress on the modifications
    [4mm_deli.dxf, 6mm_les_izrez_gor_dol.dxf, 6mm_les_izrez_levo_desno.dxf, 6mm_les_izrez_spredaj_zadaj.dxf, Building blocks.dxf]
2015-09-20 #21: Wooden hotend
    [Building blocks.dxf]
2015-10-04 Added holes for LCD, USB, HDMI and RJ45
    [4mm_deli.dxf, 6mm_les_izrez_gor_dol.dxf, 6mm_les_izrez_levo_desno.dxf, 6mm_les_izrez_spredaj_zadaj.dxf, Building blocks.dxf]
2015-11-03 Wooden hotend
    [Building blocks.dxf]
2017-02-22 Reorganized folders
    [3D Model gor dol.FCStd, 3D Model left right.FCStd, 3D Model.FCStd, 4mm_deli.dwg, 4mm_deli.dxf, 6mm_gravura_prva_stran.dwg, 6mm_les_izrez_desno - LM8UU.dxf, 6mm_les_izrez_dol - LM8UU.dxf]
2017-02-25 split blocks
    [6mm_les_izrez_desno - LM8UU.dxf, 6mm_les_izrez_dol - LM8UU.dxf, 6mm_les_izrez_levo - LM8UU.dxf]
2017-02-25 cleaned dxf
    [6mm_les_izrez_desno - LM8UU.dxf, 6mm_les_izrez_levo - LM8UU.dxf]
2017-02-25 Generate cut files
2017-02-25 first draft of script for generating cut files
2017-02-26 Split up objects
    [6mm_les_izrez_dol - LM8UU.dxf, 6mm_les_izrez_gor - LM8UU.dxf, 6mm_les_izrez_levo - LM8UU.dxf, 6mm_les_izrez_spredaj - LM8UU.dxf, 6mm_les_izrez_zadaj - LM8UU.dxf]
2017-03-03 Generated STL models
    [DESNO.stl, GOR.stl, LEVO.stl, movedDESNO.stl, movedGOR.stl, movedLEVO.stl]
2017-03-03 Added second cut layers
    [3D Model.FCStd, 6mm_les_izrez_desno - LM8UU.dxf, 6mm_les_izrez_gor - LM8UU.dxf, 6mm_les_izrez_levo - LM8UU.dxf, 6mm_les_izrez_spredaj - LM8UU.dxf]
2017-03-03 Generated 3D components
    [SPREDAJ.stl, ZADAJ.stl, movedSPREDAJ.stl, movedZADAJ.stl]
2017-03-04 Fixed holes
    [6mm_les_izrez_levo - LM8UU.dxf, 6mm_les_izrez_spredaj - LM8UU.dxf, 6mm_les_izrez_zadaj - LM8UU.dxf]
2017-03-04 Generated files
    [6mm_plexi_cut_windows.dxf, 6mm_plywood_cut_front_back.dxf, 6mm_plywood_cut_left_right.dxf, 6mm_plywood_cut_top_bottom.dxf]
2017-03-04 FreeCAD macros
    [Carrige #2 - 180.stl, Carrige #2.stl]
2017-03-04 Hot end holder plans
    [6mm_les_izrez_hotend_bottom.dxf, 6mm_les_izrez_hotend_side_7.dxf, 6mm_les_izrez_hotend_side_8.dxf, 6mm_les_izrez_hotend_side_9.dxf, 6mm_les_izrez_hotend_top.dxf, Building blocks.dxf]
2017-03-04 added NEMA17 motors
2017-03-04 NEMA17 motor
    [Motor_NEMA17.stl]
2017-03-09 hot end holder
    [HE_BACK.stl, HE_BOTTOM.stl, HE_FRONT.stl, HE_LEFT.stl, HE_RIGHT.stl, HE_TOP.stl, movedHE_BACK.stl, movedHE_BOTTOM.stl]
2017-03-09 fixed z position
    [movedHE_BACK.stl, movedHE_BOTTOM.stl, movedHE_FRONT.stl, movedHE_LEFT.stl, movedHE_RIGHT.stl, movedHE_TOP.stl]
2017-03-09 fixed z, again
    [movedHE_BOTTOM.stl]
2017-03-09 Added hotend holder
2017-03-12 Added Table
    [6mm_les_izrez_dol - LM8UU.dxf, 6mm_les_izrez_miza.dxf, 6mm_plexi_cut_windows.dxf, 6mm_plywood_cut_front_back.dxf, 6mm_plywood_cut_left_right.dxf, 6mm_plywood_cut_top_bottom.dxf, DESNO.stl, GOR.stl]
2018-02-03 Created yml scripts, need to be tested on Windows
    [6mm_plexi_cut_windows.dxf, 6mm_plywood_cut_front_back.dxf, 6mm_plywood_cut_left_right.dxf, 6mm_plywood_cut_top_bottom.dxf, DESNO.stl, HE_BOTTOM.stl, HE_RIGHT.stl, HE_TOP.stl]
2021-01-02 update design and remove found issues
    [6mm_les_izrez_desno - LM8UU.dxf, 6mm_les_izrez_gor - LM8UU.dxf, 6mm_les_izrez_gor - LMH12UU.dxf, 6mm_les_izrez_hotend_bottom.dxf, 6mm_les_izrez_hotend_bottom2.dxf, 6mm_les_izrez_hotend_side_6.5.dxf, 6mm_les_izrez_hotend_side_6.dxf, 6mm_les_izrez_hotend_side_7.dxf]
2021-01-03 update STL files
    [movedBACK.stl, movedBOTTOM.stl, movedFRONT.stl, movedHE_BOTTOM.stl, movedHE_TOP.stl, movedLEFT.stl, movedRIGHT.stl, movedTABLE.stl]
2021-01-03 update and prepare first beta version
    [6mm_les_izrez_desno - LM8UU.dxf, 6mm_les_izrez_dol - LM8UU.dxf, 6mm_les_izrez_gor_dol - LM8UU.dxf, 6mm_les_izrez_gor_dol.dxf, 6mm_les_izrez_levo - LM8UU.dxf, 6mm_les_izrez_levo_desno - LM8UU.dxf, 6mm_les_izrez_levo_desno.dxf, 6mm_les_izrez_spredaj_zadaj - LM8UU.dxf]
